Curtis-Milo/Capstone/RasberryPi/images/ceiling8.jpg

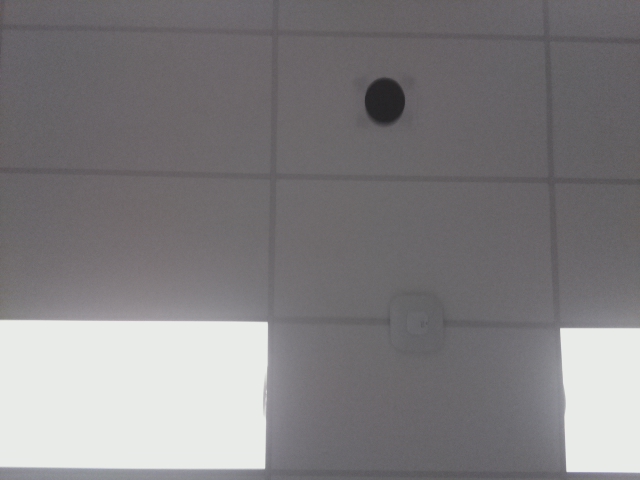
RasberryPi/images/ceiling8.jpg
