Curtis-Milo/Capstone/RasberryPi/images/ceiling1.jpg

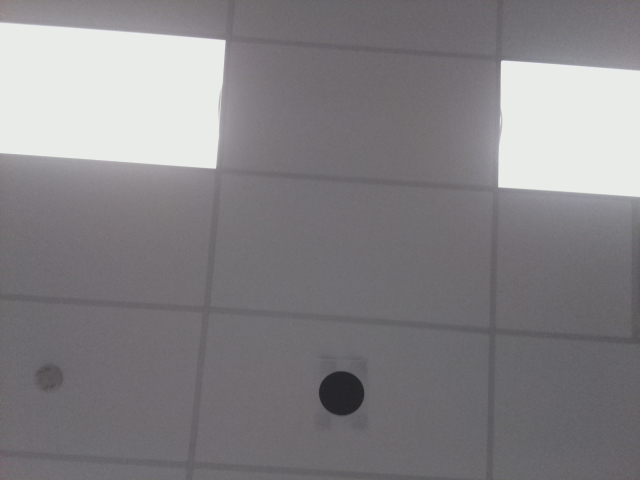
RasberryPi/images/ceiling1.jpg
