Curtis-Milo/Capstone/Documentation/5-System_Design/System_Design.tex

% Document uses 12 pt font
% 1 in margins
% Contains a relative path for images

\documentclass [10pt]{article}

% page geometry 
\usepackage[margin=1in]{geometry}

% ----------  PACKAGES START ------------ %
% Math Packages
\usepackage{amsmath}
\usepackage{mathtools}

% Table cell color package and highlighting
\usepackage[table,xcdraw]{xcolor}
\usepackage{color,soul}

% VIC title package
%\usepackage{cabin}
\usepackage[T1]{fontenc}

% default font package
%\usepackage{times}
\usepackage{helvet}
%\renewcommand{\familydefault}{\sfdefault}

% ---------- End Font Packages -------------- %

\usepackage{listings}

%\definecolor{dkgreen}{rgb}{0,0.6,0}
%\definecolor{gray}{rgb}{0.5,0.5,0.5}
%\definecolor{mauve}{rgb}{0.58,0,0.82}
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
\usepackage{longtable}
\usepackage{multirow}
\usepackage{multicol}
\usepackage{multirow}
\usepackage{array}
\renewcommand{\arraystretch}{1.2}% Spread rows out evenly in table
\setlength{\LTpre}{0.5pt} % Reduces white space around tables (top)
%\setlength{\LTpost}{0pt} % Reduces white space around tables (bottom)

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

% List package
\usepackage{enumitem}
\setenumerate{itemsep=0pt, itemindent=0in,leftmargin=0.5in}

% Paragraph parameter

\setlength{\parindent}{0pt}

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

% ------------- Creates a click-able Table of Contents  End--------------- %

% ---------- PACKAGES END ------------ %

% -------- SECTION AND SUBSECTION FORMATING START -------- % 
% starts the 
%\setcounter{section}{1}

\titleformat{\section} % Section
{\normalfont \fontsize{14}{14} \bfseries}{}{0em}{\colorsection}

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

% Makes a background color
\titleformat{\subsection} % Subsection
{\normalfont \fontsize{12}{12}  \bfseries}{}{0em}{\colorsubsection }

\newcommand{\colorsubsection}[1]{%
  \colorbox{subsectionC}{\parbox{\dimexpr \textwidth -1\fboxsep}{\large\thesubsection\ #1}}}

% Makes a background color
\titleformat{\subsubsection} % Subsubsection
{\normalfont \fontsize{12}{12} \bfseries}{}{0em}{\colorsubsubsection}

\newcommand{\colorsubsubsection}[1]{%
  \colorbox{subsubsectionC}{\parbox{\dimexpr\textwidth-1\fboxsep}{\thesubsubsection\ #1}}}

% -------- SECTION AND SUBSECTION FORMATING END -------- % 
\usepackage{lipsum}

% -----  IMAGE PATH START -----%
% Relative Image Path
\graphicspath {figures/}
% -----  IMAGE PATH END -----%

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

%------------------------------TOC FORMAT START --------------------------------%
\usepackage{tocloft}

% Section indentations
\cftsetindents{section}{0em}{1.5em}
\cftsetindents{subsection}{1em}{2em}
\cftsetindents{subsubsection}{2em}{3em}

% Toc title size
\renewcommand\cfttoctitlefont{\Large\bfseries}
\renewcommand*\contentsname{Table of Contents}

\newcommand{\carSpeed}{1.4\ m/s}
\newcommand{\intersectionLength}{0.6\ m}

% Removes bold headings from toc
%\renewcommand{\cftsecfont}{\normalfont}

% Removes bold heading page numbers from toc
\renewcommand{\cftsecpagefont}{\normalfont}

% add dots after headings
%\renewcommand{\cftsecleader}{\cftdotfill{\cftdotsep}} 

% number of section headings we want to see in toc
\setcounter{tocdepth}{2}

% Spaceing before headings in toc
\setlength{\cftbeforesecskip}{6pt}

% ------------------------------TOC FORMAT END --------------------------------%

% ------------------- START HEADER AND FOOTER ---------------------------%
\usepackage{fancyhdr}

% Helps with the n of total n pages
\usepackage{lastpage}

\pagestyle{fancy}

% Header
\lhead{Draft Component Design}
\rhead{Revision: 0}
\fancyhead[LE,CO]{Group 9: LazyBots}

% Removes line under the header 
\renewcommand{\headrulewidth}{0pt}
\setlength{\headsep}{.2in}

% Footer 

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

% ------------------- END HEADER AND FOOTER ---------------------------%

% -------------- DOCUMENT START ---------------%
\begin{document}

% --------- TITLE PAGE START ------- %
\begin {center} 

\thispagestyle{empty}
\vspace*{5cm}

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

{%\fontfamily{\cabinfamily}\selectfont
\Huge{LazyBots} }

\vspace{1 cm}
{\Large\textbf{\textsc{McMaster University}}\\}  \vspace {1cm}
{\Large Draft System Design\\ \vspace {0.4 cm} SE 4GA6 \& TRON 4TB6}  \vspace {1cm}

{\large \textsc{Group 9} \\} \vspace{1cm}

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

\end{center}

% --------- TITLE PAGE END------- %

\pagebreak

% Inserting table of contents and table of figures 

\tableofcontents
\listoftables
\listoffigures

\pagebreak

% -----------  REVISION HISTORY START ----------- %

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

\caption{LazyBots Table of Revisions} 
\end{longtable}

\pagebreak

%---------------------------- PROJECT DRIVERS ------------------------%
% heading in document

% -------------- START INTRODUCTION ---------------- %

% ------------------------------------------------------- PURPOSE ------------------------------------------------------- %
\section {Purpose}

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

% ------------------------------------------------------- Scope ------------------------------------------------------- %

\subsection{Scope}

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

% ------------------------------------------------------- Context Diagram ------------------------------------------------------- %

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

% ---------------------------------------------------- Diagram of Components ----------------------------------------------------- %

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

% ------------------------------------------------------------ Assumptions ------------------------------------------------------------- %

\subsection{Assumptions}

Alfred's assumption are represented in the tables below.  \\

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

\subsection{Components to Requirements}

% ------------------------------------------------------- SYSTEM VARIABLES ------------------------------------------------------- %

\section{System Variables}

% ---------------------------------------------- Monitored and Controlled Variables ----------------------------------------------- %

\subsection{Monitored and Controlled Variables}
The following is a list of variables that will be monitored. \\

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

The following is a list of variables that will be controlled. \\

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

% ------------------------------------------------------- Constants ------------------------------------------------------- %

\subsection{Constants}

The following is a list of system constants. \\

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

% ----------------------------------------------------- BEHAVIOUR OVERVIEW ---------------------------------------------------- %

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

% ------------------------------------------------ COMPONENT TRACEABILITY ------------------------------------------------- %

\section{Component Traceability}

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

\pagebreak

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

\pagebreak

% -------------------------------------------------- COMPONENT OVERVIEW ---------------------------------------------------- %

\section{Component Overview}

% ----------------------------------------------------- Ordering System Module ---------------------------------------------------- %
\subsection{Ordering System Module}

% ----------------------------------------------------- Description ---------------------------------------------------- %

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

% ----------------------------------------------------- Inputs and Outputs ---------------------------------------------------- %
\subsubsection{Inputs and Outputs}

\textbf{Inputs:}  User input defining:\\

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

\textbf{Outputs:} Packaged Information within HTTP Request for: \\

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

% ----------------------------------------------------- Exception Handling ---------------------------------------------------- %
\subsubsection{Exception Handling}

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

% ----------------------------------------------------- Timing Constriants ---------------------------------------------------- %

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

% ----------------------------------------------------- Initialization ---------------------------------------------------- %

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

% --------------------------------------------------- Manager Login Page Module -------------------------------------------------- %

\subsection{Manager Login Page Module}

% ----------------------------------------------------- Description ---------------------------------------------------- %

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

% ----------------------------------------------------- Inputs and Outputs ---------------------------------------------------- %

\subsubsection{Inputs and Outputs}

\textbf{Inputs: } \newline

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

\textbf{Outputs: } To be displayed to the user.\newline
\begin{longtable}{|l|l|l|l|l|}\hline 
	\rowcolor{tableCell}\textbf{Output Name} & \textbf{Output Type} & \textbf{Range} & \textbf{Units} & \textbf{Comment(s)} \\ \hline
	$  FailureMessage $ & String & 10 chars & N/A & Failure message if there is an incorrect information  \\ \hline
	\rowcolor{tableCell}$  GotoPage $ & Action & N/A  & N/A & navigating to the correct page if it was a success. \\ \hline
\end{longtable}

% ----------------------------------------------------- Exception Handling ---------------------------------------------------- %
\subsubsection{Exception Handling}

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

% ----------------------------------------------------- Timing Constraints ---------------------------------------------------- %

\subsubsection{Timing Constraints}
Given optimal networking conditions, the server must respond with $ t_{timeout} $ seconds.

% ----------------------------------------------------- Initialization ---------------------------------------------------- %

\subsubsection{Initialization}
This will default to a HTML page with no information.

% ------------------------------------------- Manager Station Map Software Module ------------------------------------------ %

\subsection{Manager Station Map Software Module}

% ----------------------------------------------------- Description ---------------------------------------------------- %

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

% ----------------------------------------------------- Inputs and Outputs ---------------------------------------------------- %

\subsubsection{Inputs and Outputs}

\textbf{Inputs:} User input defining:\\

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

\textbf{Outputs: }A text file that contains the following information. \\

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

% ----------------------------------------------------- Exception Handling ---------------------------------------------------- %
\subsubsection{Exception Handling}

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

% ----------------------------------------------------- Timing Constraints ---------------------------------------------------- %

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

% ----------------------------------------------------- Initialization ---------------------------------------------------- %

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

% ---------------------------------------- Manager Station Request Software Module ----------------------------------------- %

\subsection{Manager Station Request Software Module}

% ----------------------------------------------------- Description ---------------------------------------------------- %

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

% ----------------------------------------------------- Inputs and Outputs ---------------------------------------------------- %

\subsubsection{Inputs and Outputs}

\textbf{Inputs: } \\

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

% ----------------------------------------------------- Exception Handling ---------------------------------------------------- %
\subsubsection{Exception Handling}

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

% ----------------------------------------------------- Timing Constraints ---------------------------------------------------- %

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

% ----------------------------------------------------- Initialization ---------------------------------------------------- %

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

% ------------------------------------------------- Back End Web Service Module ------------------------------------------------ %

\subsection{Back End Web Service Module}

% ----------------------------------------------------- Description ---------------------------------------------------- %

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

% ----------------------------------------------------- Inputs and Outputs ---------------------------------------------------- %

\subsubsection{Inputs and Outputs}

\textbf{Inputs: } \\

\begin{longtable}{| p{.15\textwidth} | p{.15\textwidth} | p{.08\textwidth} | p{.06\textwidth} | p{.45\textwidth} |}\hline 
	\rowcolor{tableCell}\textbf{Input Name} & \textbf{Input Type} & \textbf{Range} & \textbf{Units} & \textbf{Comment(s)} \\ \hline
	$ HttpReq_{Orders} $ & HTTP Request & N/A & N/A & HTTP request package with the information for drink orders. \\ \hline
	\rowcolor{tableCell}$ Map_{textfile} $ & Text File & N/A & N/A & A text file with a map of the restaurant \\ \hline
	$  errors_{Alfred} $ & Unsigned Byte & [0, $2^{8}$]& N/A & Errors from Alfred \\ \hline
	\rowcolor{tableCell}$  UserName $ & String & 10 chars & N/A & N/A\\ \hline
	$  Password $ & HashCode & N/A & N/A &  Success result for authenticated results. \\ \hline
\end{longtable}

\textbf{Outputs: } \\

\begin{longtable}{| p{.15\textwidth} | p{.15\textwidth} | p{.08\textwidth} | p{.06\textwidth} | p{.45\textwidth} |}\hline 
	\rowcolor{tableCell}\textbf{Output Name} & \textbf{Output Type} & \textbf{Range} & \textbf{Units} & \textbf{Comment(s)} \\ \hline
	$ HttpReq_{Orders} $ & HTTP Request & N/A & N/A & HTTP request package with the information for drink orders. \\ \hline
	\rowcolor{tableCell}$ Map_{textfile} $ & Text File & N/A & N/A & A text file with a map of the restaurant \\ \hline
	$  errors_{Alfred} $ & Unsigned Byte & [0, $2^{8}$]& N/A & Errors from Alfred \\ \hline
	\rowcolor{tableCell}$  Login_{Status} $ & String & 10 chars & N/A & Login Success or Fail \\ \hline
	$  Http_{Result} $ & String & 10 chars & N/A & N/A\\ \hline
\end{longtable}

% ----------------------------------------------------- Exception Handling ---------------------------------------------------- %
\subsubsection{Exception Handling}

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

% ----------------------------------------------------- TIming Constraints ---------------------------------------------------- %

\subsubsection{Timing Constraints}
Given optimal networking conditions, the server must respond with  $ t_{timeout} $ seconds.

% ----------------------------------------------------- Initialization ---------------------------------------------------- %

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

% ----------------------------------------------------- Alfred Manager Module ---------------------------------------------------- %

\subsection{Alfred Manager Module}

% ----------------------------------------------------- Description ---------------------------------------------------- %

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

% ----------------------------------------------------- Inputs and Outputs ---------------------------------------------------- %

\subsubsection{Inputs and Outputs}

\textbf{Inputs: } \\

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

\textbf{Outputs: } \\

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

% ----------------------------------------------------- Exception Handling ---------------------------------------------------- %
\subsubsection{Exception Handling}

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

% ----------------------------------------------------- TIming Constraints ---------------------------------------------------- %

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

% ----------------------------------------------------- Initialization ---------------------------------------------------- %

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

% --------------------------------------------- Raspberry Pi Specifications -------------------------------------------- %

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

% --------------------------------------------- Alfred Drive-Train Module -------------------------------------------- %

\subsection{Alfred Drive-Train Module}

% --------------------------------------------- Description -------------------------------------------- %

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

% --------------------------------------------- Inputs and Outputs -------------------------------------------- %

\subsubsection{Inputs and Outputs}

\textbf{Inputs: } \\

\begin{longtable}{| p{.15\textwidth} | p{.15\textwidth} | p{.15\textwidth} | p{.06\textwidth} | p{.45\textwidth} |}\hline 
	\rowcolor{tableCell}\textbf{Input Name} & \textbf{Input Type} & \textbf{Range} & \textbf{Units} & \textbf{Comment(s)} \\ \hline
	$ Map $ & Graph & N/A & N/A & Graph of the text file with a map of the restaurant \\ \hline
	\rowcolor{tableCell}$ NextNode $ & Node & [(0,0), (length($Map)$, width($Map$)] & N/A & The next node to travel to \\ \hline
	$ w_{wheel_{left}} $ & Float & [0, $ 100 $]& rad/s &  Left Encoder Input\\ \hline
	\rowcolor{tableCell}$ w_{wheel_{right}} $ & Float & [0, $ 100 $]& rad/s & Right Encoder Input \\ \hline
	$  d_{objects} $ & Float[] & [0, 10.0]& m &  N/A\\ \hline
	\rowcolor{tableCell}$ Marker_{PosX} $ & Unsigned Integer & [0,$2^{16}$] & Pixels &  N/A\\ \hline
	$ Marker_{PosY} $ & Unsigned Integer & [0,$2^{16}$] & Pixels & N/A\\ \hline
	\rowcolor{tableCell}$ b_{NextMarkerFound} $ & Boolean & [0,1] & N/A & N/A \\ \hline
	$  V_{batt} $ & Float & [0, 20.0]& m &  N/A\\ \hline
\end{longtable}

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

% ----------------------------------------------------- Exception Handling ---------------------------------------------------- %
\subsubsection{Exception Handling}

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

% --------------------------------------------- Timing Constraints -------------------------------------------- %

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

% --------------------------------------------- Initialization -------------------------------------------- %

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

% --------------------------------------------- Diagram of Simulink System -------------------------------------------- %

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

% --------------------------------------------- Diagram of Simulink System -------------------------------------------- %

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

% --------------------------------------------- DC Motor Specifications -------------------------------------------- %

\subsubsection{DC Motor Specifications}
Manufactured Part Number: 393111-01\\
Rated Voltage: 18V\\
Current: 3A-5A\\

% --------------------------------------------- H-Bridge Specifications -------------------------------------------- %

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

% --------------------------------------------- Encoder Specifications -------------------------------------------- %

\subsubsection{Encoder Specifications}
Shaft Diameter 6mm\\
Working Range: 3-5V DC\\

% --------------------------------------------- Alfred Pumping System Module -------------------------------------------- %

\subsection{Alfred Pumping System Module}

% --------------------------------------------- Description -------------------------------------------- %

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

% --------------------------------------------- Inputs and Outputs -------------------------------------------- %

\subsubsection{Inputs and Outputs}

\textbf{Inputs: } \\

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

\textbf{Outputs: } \\

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

% ----------------------------------------------------- Exception Handling ---------------------------------------------------- %
\subsubsection{Exception Handling}

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

% --------------------------------------------- TIming Constraints -------------------------------------------- %

\subsubsection{Timing Constraints}
This module will have to dispense the drink within $ t_{maxpump} $

% --------------------------------------------- Initialization -------------------------------------------- %

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

% --------------------------------------------- Diagram of DC Pump Control System -------------------------------------------- %

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

% --------------------------------------------- DC Pump Circuit Diagram -------------------------------------------- %

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

\pagebreak

% --------------------------------------------- Liquid Temperature Circuit Diagram -------------------------------------------- %

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

% --------------------------------------------- Weight Detection Circuit Diagram -------------------------------------------- %

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

% --------------------------------------------- DC Pump Specifications -------------------------------------------- %

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

% --------------------------------------------- Arduino Mega Specifications -------------------------------------------- %

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

% --------------------------------------------- Container Specifications -------------------------------------------- %

\subsubsection{Container Specifications} 

Manufacture : Rubbermaid \\
Dimensions: 10 1/2" x 9" x 4" 
Capacity: 18 Cups/4.2 L\\

% --------------------------------------------- Tubing Specifications -------------------------------------------- %

\subsubsection{Tubing Specifications}
Manufacture : Plumb Craft \\
Diameter: 1/4"ID Food Grade Tubing will be used.\\

% --------------------------------------------- Alfred Image Processing Module -------------------------------------------- %

\subsection{Alfred Image Processing Module }

% --------------------------------------------- Description -------------------------------------------- %

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

% --------------------------------------------- Inputs and Outputs -------------------------------------------- %

\subsubsection{Inputs and Outputs}

\textbf{Inputs: } \\

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

\textbf{Outputs: } \\

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

% ----------------------------------------------------- Exception Handling ---------------------------------------------------- %
\subsubsection{Exception Handling}

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

% --------------------------------------------- Timing Constraints -------------------------------------------- %

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

% --------------------------------------------- Initialization -------------------------------------------- %

\subsubsection{Initialization}
This module start by the drive-train application.

% --------------------------------------------- Raspberry Pi Specifications -------------------------------------------- %

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

% --------------------------------------------- Modules Likelihood of Change -------------------------------------------- %

\section{Likelihood of Change}

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

\multicolumn{1}{|c|}{Manager Login Page Module}& 
\multicolumn{1}{|c|}{Very Unlikely} & Key implementation aspect \\ \hline

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

\multicolumn{1}{|c|}{Alfred Manager Module}& 
\multicolumn{1}{|c|}{Very Unlikely} & Key implementation aspect \\ \hline

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

\multicolumn{1}{|c|}{Alfred Image Processing Module}& 
\multicolumn{1}{|c|}{Very Unlikely} & Key implementation aspect \\ \hline

\end{longtable}

% --------------------------------------------- Normal Operation -------------------------------------------- %

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

% --------------------------------------------- Undesired Event Handling -------------------------------------------- %

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

% --------------------------------------------- References -------------------------------------------- %

\section{References}

\textbf{Raspberry pi data sheet}
\begin{verbatim}
[1]"Exploring Raspberry Pi", 2017. [Online]. 
Available: http://docs-europe.electrocomponents.com/webdocs/14ba/0900766b814ba5fd.pdf. 
[Accessed: 23- Dec- 2017].
\end{verbatim}

\textbf{Arduino Mega Information}
\begin{verbatim}
[2] "Arduino Mega". [Online]. Available:
https://www.arduino.cc/en/Main/ArduinoBoardMega. [Accessed: 23- Dec- 2017].
\end{verbatim}

\textbf{DC Pump Information}
\begin{verbatim}
[3] "3-6V Mini Micro Submersible Pumps DC Motor Pump Water Pump - 80-120L/H". [Online]. 
Available: 
https://www.amazon.ca/gp/product/B01LWQCXEL/ref=oh_aui_detailpage_o02_s00?ie=UTF8&psc=1.
[Accessed: 23- Dec- 2017].
\end{verbatim}
\textbf{Pump Container Information}
\begin{verbatim}
[4] "Rubbermaid 1856059 Modular Cereal Keeper". [Online]. 
Available: 
https://www.amazon.ca/gp/product/B00BEUDXRW/ref=oh_aui_detailpage_o09_s00?ie=UTF8&psc=1. 
[Accessed: 23- Dec- 2017].
\end{verbatim}

\textbf{Raspberry camera pi data sheet}
\begin{verbatim}
[4] "CAMERA MODULE". [Online]. Available:
https://www.raspberrypi.org/documentation/hardware/camera/. [Accessed: 23- Dec- 2017].
\end{verbatim}
\end{document}
