Curtis-Milo/Capstone/Documentation/2-Project_Goals/Goals.tex

% Document uses 12 pt font
% 1 in margins
% Contains a relative path for images

\documentclass [11pt]{article}

% page geometry 
\usepackage[margin=1in]{geometry}

% ----------  PACKAGES START ------------ %

% Table cell color
\usepackage[table]{xcolor}

% VIC title package
\usepackage{cabin}
\usepackage[T1]{fontenc}

% default font package
%\usepackage{times}
\usepackage{helvet}
%\renewcommand{\familydefault}{\sfdefault}

% ---------- End Font Packages -------------- %

% Title Packages
\usepackage{titlesec}
\usepackage{titletoc}

% Image Package
\usepackage{graphicx}

% Table Packages
\usepackage{longtable}
\usepackage{multirow}
\usepackage{multicol}
\usepackage{multirow}
\usepackage{array}
\renewcommand{\arraystretch}{1.2}% Spread rows out evenly in table

% Color Packages
\usepackage{color}   
\definecolor{sectionC}{rgb}{0.95,0.52,.0}
\definecolor{subsectionC}{rgb}{1.0,.64,.26}
\definecolor{subsubsectionC}{rgb}{1.0,.87,.68}
\definecolor{tableCell}{rgb}{.98,.81,.69}

% List package
\usepackage{enumitem}
\setenumerate{itemsep=0pt, itemindent=0in,leftmargin=0.5in}

% Paragraph parameter

\setlength{\parindent}{0pt}

% ------------- Creates a linked Table of Contents  Start --------------- %
\usepackage{hyperref}
\hypersetup{
colorlinks=true, %set true if you want colored links
linktoc=all,     %set to all if you want both sections and subsections linked
linkcolor=black,}  %choose some color if you want links to stand out

% ------------- Creates a click-able Table of Contents  End--------------- %

% ---------- PACKAGES END ------------ %

% ------------------- START HEADER AND FOOTER ---------------------------%
\usepackage{fancyhdr}

% Helps with the n of total n pages
\usepackage{lastpage}

\pagestyle{fancy}

% Header
\lhead{Project Goals }
\rhead{Revision: 2}
\fancyhead[LE,CO]{Group 9: LazyBots}

% Removes line under the header 
\renewcommand{\headrulewidth}{0pt}
\setlength{\headsep}{.2in}

% Footer 

% Set the right side of the footer to be the page number
\fancyfoot[R]{Page \textbf{\thepage}\ of \textbf{\pageref{LastPage}}}
\fancyfoot[C]{}

% ------------------- END HEADER AND FOOTER ---------------------------%

% ------------------- START ROTATE FOOTER ---------------------------%
\usepackage{everypage}

\newcommand{\Lpagenumber}{\ifdim\textwidth=\linewidth\else\bgroup
  \dimendef\margin=0
  \ifodd\value{page}\margin=\oddsidemargin
  \else\margin=\evensidemargin
  \fi
  \raisebox{\dimexpr -\topmargin-\headheight-\headsep-.8\linewidth}[0pt][0pt]{%
    \rlap{\hspace{\dimexpr \margin+\textheight}%
    \llap{\rotatebox{0}{Page \textbf{\thepage}\ of \textbf{\pageref{LastPage}}}}}}%
\egroup\fi}
\AddEverypageHook{\Lpagenumber}%

% ------------------- END ROTATE FOOTER ---------------------------%

% -------- SECTION AND SUBSECTION FORMATING START -------- % 
% starts the 
%\setcounter{section}{1}

\titleformat{\section} % Section
{\normalfont \fontsize{14}{14} \bfseries}{}{0em}{\colorsection}

% Makes a background color
\newcommand{\colorsection}[1]{%
  \colorbox{sectionC}{\parbox{\dimexpr\textwidth-1\fboxsep}{\color{black}\Large\thesection\ \hspace{1mm} #1}}}

% Makes a background color
\titleformat{\subsection} % Subsection
{\normalfont \fontsize{12}{12}  \bfseries}{}{0em}{\colorsubsection }

\newcommand{\colorsubsection}[1]{%
  \colorbox{subsectionC}{\parbox{\dimexpr \textwidth -1\fboxsep}{\large\thesubsection\ #1}}}

% Makes a background color
\titleformat{\subsubsection} % Subsubsection
{\normalfont \fontsize{12}{12} \bfseries}{}{0em}{\colorsubsubsection}

\newcommand{\colorsubsubsection}[1]{%
  \colorbox{subsubsectionC}{\parbox{\dimexpr\textwidth-1\fboxsep}{\thesubsubsection\ #1}}}

% -------- SECTION AND SUBSECTION FORMATING END -------- % 
\usepackage{lipsum}

% -----  IMAGE PATH START -----%
% Relative Image Path
\graphicspath {figures/}
% -----  IMAGE PATH END -----%

% ------ PARAGRAPH FORMAT START ----%
%\setlength{\parskip}{.2em}% Sets the space between new paragraph items 
\setlength{\parindent}{0em} % paragraph indent
% ------ PARAGRAPH FORMAT END ----%

%------------------------------TOC FORMAT START --------------------------------%
\usepackage{tocloft}

% Section indentations
\cftsetindents{section}{0em}{1.5em}
\cftsetindents{subsection}{1em}{2em}
\cftsetindents{subsubsection}{2em}{3em}

% Toc title size
\renewcommand\cfttoctitlefont{\Large\bfseries}
\renewcommand*\contentsname{Table of Contents}

% Removes bold headings from toc
%\renewcommand{\cftsecfont}{\normalfont}

% Removes bold heading page numbers from toc
\renewcommand{\cftsecpagefont}{\normalfont}

% add dots after headings
%\renewcommand{\cftsecleader}{\cftdotfill{\cftdotsep}} 

% number of section headings we want to see in toc
\setcounter{tocdepth}{2}

% Spaceing before headings in toc
\setlength{\cftbeforesecskip}{6pt}

% ------------------------------TOC FORMAT END --------------------------------%

% -------------- DOCUMENT START ---------------%
\begin{document}
% --------- TITLE PAGE START ------- %
\begin {center} 

\thispagestyle{empty}
\vspace*{5cm}

% Logo Insertion
\begin {figure}[h!]
\centering
\hspace{-10mm}\includegraphics [scale = .3, trim={.4cm 0 .8cm 0},clip] {figures/alfred.png}
\end {figure}

{\fontfamily{\cabinfamily}\selectfont
\Huge{LazyBots} }

\vspace{1 cm}
{\Large\textbf{\textsc{McMaster University}}\\}  \vspace {1cm}
{\Large Project Goals\\ \vspace {0.4 cm} SE 4GA6 \& TRON 4TB6}  \vspace {1cm}

{\large \textsc{Group 9} \\} \vspace{1cm}

\begin{tabular}{ l c  l}
Karim Guirguis & & 001307668 \\
David Hemms & & 001309228 \\
Marko Laban & & 001300989 \\
Curtis Milo & & 001305877 \\
Keyur Patel & & 001311559 \\
Alexandra Rahman & & 001305735
\end{tabular}

\end{center}

% ------------------------------------------------------- TITLE PAGE END -------------------------------------------------------- 

\pagebreak

% ------------------------------------------------------- Contents Guide -------------------------------------------------------

\tableofcontents
\listoftables

\pagebreak

% ------------------------------------------------------- Revision History -------------------------------------------------------

\section{Revisions}
\begin{longtable}{| p{.23\textwidth } | p{.23\textwidth } | p{.23\textwidth } | p{.21\textwidth } |}
\hline 
\centering \textbf{Date} & 
\multicolumn{1}{c}{\textbf {Revision Number}} &
\multicolumn{1}{|c}{\textbf {Authors}} & 
\multicolumn{1}{|c|}{\textbf {Comments}} \\ \hline

\multirow{4}{*}{\centering October 5\textsuperscript{th}, 2017}  & 
\multirow{4}{*}{Revision 0}& 
		{Karim Guirguis \newline
		David Hemms \newline
		Marko Laban \newline
		Curtis Milo \newline
		Keyur Patel \newline
		Alexandra Rahman} &
 \multirow{4}{*}{-} \\ 
\hline 

\multirow{4}{*}{\centering December 14\textsuperscript{th}, 2017}  & 
\multirow{4}{*}{Revision 1}& 
		{Karim Guirguis \newline
		David Hemms \newline
		Marko Laban \newline
		Curtis Milo \newline
		Keyur Patel \newline
		Alexandra Rahman} &
{Made one of the extended goals a project goal.} \\
\hline 

\multirow{4}{*}{\centering February 25\textsuperscript{th}, 2018}  & 
\multirow{4}{*}{Revision 2}& 
		{Karim Guirguis \newline
		David Hemms \newline
		Marko Laban \newline
		Curtis Milo \newline
		Keyur Patel \newline
		Alexandra Rahman} &
{Fixed layout and grammatical errors. Revised all project goals, specifically G6.} \\
\hline 

\caption{Table of Revisions}
\end{longtable}

\pagebreak

% ------------------------------------------------------ Problem Statement -----------------------------------------------------

\section{Problem Statement}

\indent\indent Many restaurants experience a rush of customers which can overwhelm serving staff as they juggle multiple tasks. Simple tasks such as getting drinks and refilling them can be costly, time wise, for a server and are often one of the first tasks overlooked. Thus leaving the customers unattended or with a feeling of neglect. Alfred is a serving assist that aims to remedy this problem by serving drinks to customers table-side. Alfred will arrive at the customer's table once an order has been placed and received, then will dispense the drink without the need to involve the server. 

% ------------------------------------------------------ Product Purpose -----------------------------------------------------

\section{Product Purpose}

\indent\indent Alfred will allow customers to order drinks through an application, after which Alfred will then navigate its way to their table to dispense the drinks ordered. Furthermore, Alfred will be able to identify objects in its path or tripping hazards and handle each scenario with the appropriate reaction. To ensure safety measures are met, Alfred will return to home base when the temperature of the liquids exceeds industry standard, the liquid supply levels are below a set amount or if the power supply is running low.

% -------------------------------------------------- Goals that Constitute Success -------------------------------------------------

\section{Project Goals that Constitute Success }
The minimum criteria for success of this project are as follows:

\begin{enumerate}[label=M\arabic*:, ref =\arabic*, leftmargin=0.5in]

	\item Alfred will be able to receive drink orders from an interface.
	\item Alfred will follow a predetermined path.
	\item Alfred will be able to arrive at the table who has placed an order.
	\item Alfred will dispense drinks autonomously.
	\item Alfred will notify the user that a drink is ready.
	
\end{enumerate}

% ------------------------------------------------------ Project Goals -----------------------------------------------------

\section{Project Goals}
The goals that constitute success are as follows:

\begin{enumerate}[label=G\arabic*:, ref =\arabic*, leftmargin=0.5in]
	
	\item Alfred will stay within the predetermined pathways.
	\item Alfred will conform to the food safety standards. 
	\item Alfred will return to home base when power supply and supply levels are low as well as when food safety standards are not met.
	\item Alfred will avoid obstacles and tripping hazards along pathways.
	\item Alfred will reduce product waste and over-pouring.	
	\item Alfred will allow the users to create and modify restaurant layouts through an interface.

\end{enumerate}

% ------------------------------------------------------ Extended Goals -----------------------------------------------------
\section{Extended Project Goals}
The goals that will exceed the definition of success are as follows: 

\begin{enumerate}[label=E\arabic*:, ref =\arabic*, leftmargin=0.5in]	

	\item Alfred will be modular to allow integration of existing POS (point-of-sale) systems.
	\item Alfred will be able to dispense correct amounts of liquid for different cup sizes.

\end{enumerate}

\end{document}
