Curtis-Milo/Capstone/Documentation/8-Presentation/Capstone.pptx

## LazyBots

Sfwr eng 4G06A & Tron 4TB6a

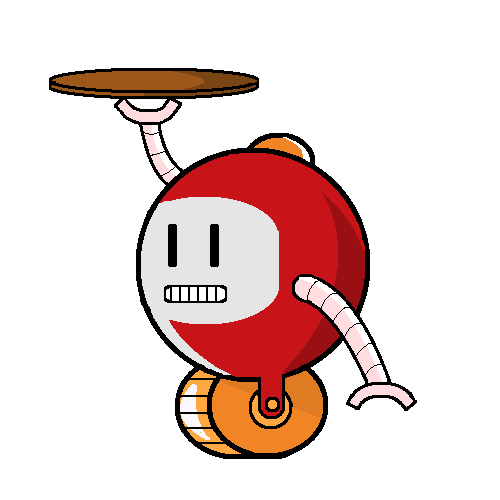
[picture p31: figure]

## Meet the Team

- Karim Guirguik
- David Hemms
- Marko Laban
- Curtis Milo
- Keyur Patel
- Alexandra Rahman
- Alfred

Photo of the Team in alphabetical order

## Meet Alfred

- A new take on a dumb waiter
- A self driving robot
- A drink dispenser

Picture of Alfred

## How Alfred Interacts in Social Settings

- Restaurant Client
- A user orders a drink via Android App
- Alfred will navigate to the customers table
- The correct drink will be dispensed
- Alfred will return to Home Base

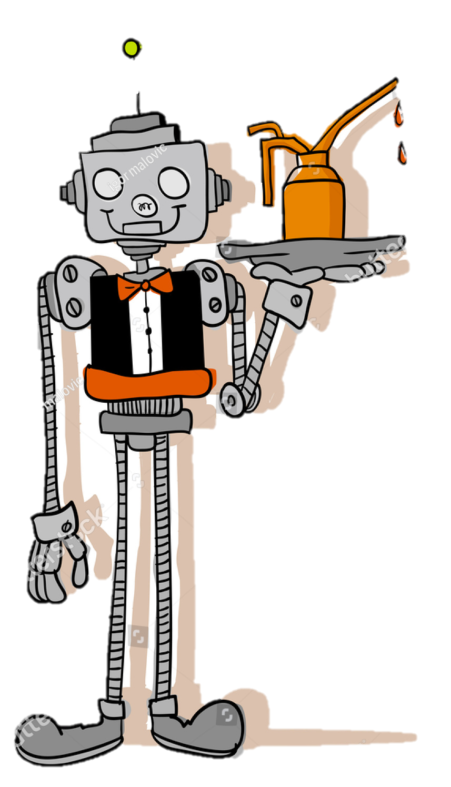
[picture p32: figure]

## How Alfred Interacts with Staff

- Restaurant Staff
- Staff will refill the drink containers
- Staff will change out the power supply
- Restaurant Management
- Management will be able to create and modify restaurant layout
- Management will be able to assign available drinks
- Management will be able to view error reports
- Management will be able to call Alfred to Home Base

## Layout of Restaurant

Layout of the restsurant

## Alfred in Action

Demo of Alfred

## The Magic Behind Alfred

- The Mechanical Design

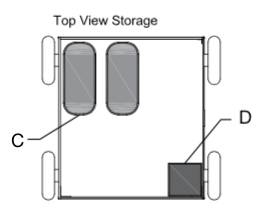
[picture p33: figure]
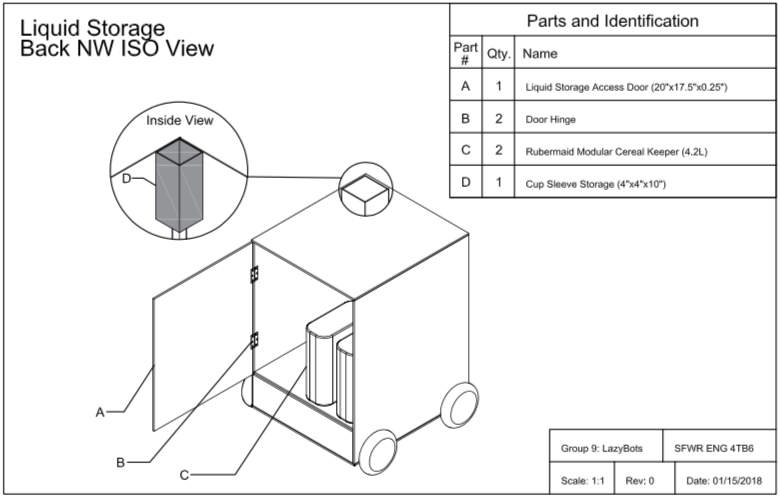
[picture p34: figure]
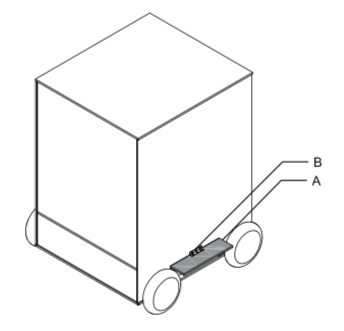
[picture p35: figure]

## The Magic Behind Alfred

- Electrical Design

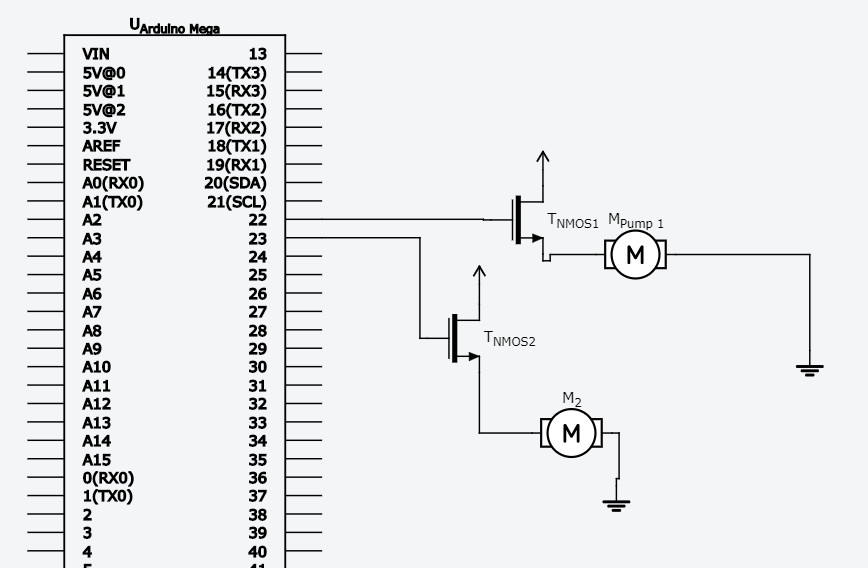
[picture p36: figure]
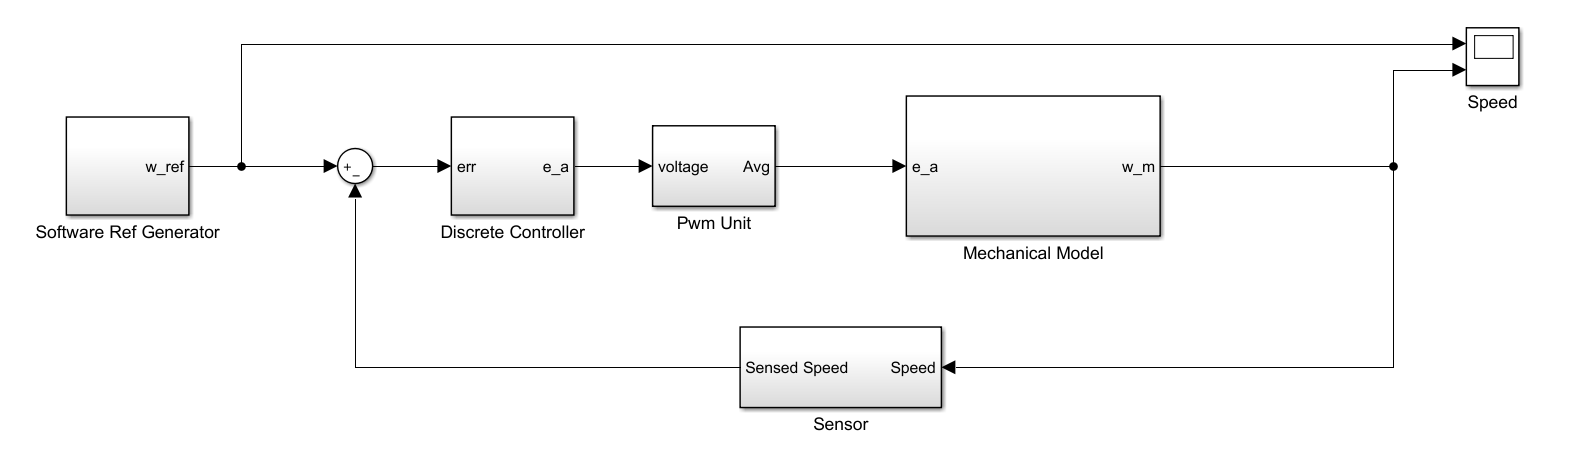
[picture p37: figure]

## The Magic Behind Alfred

- Software Design


## Future Enhancements

- Integrate Alfred’s system to existing Point of Sale Systems
- Upgrading the Dispensing System

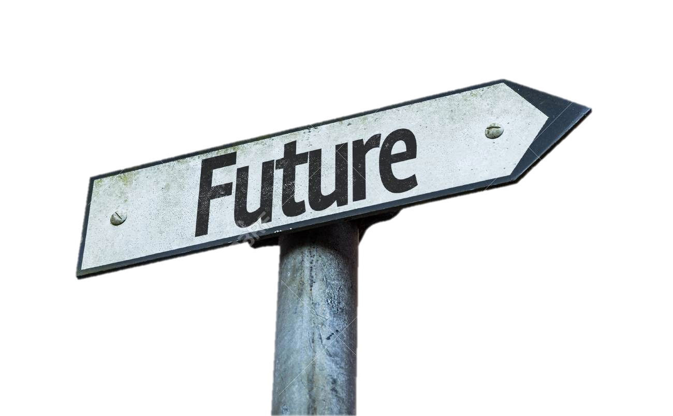
[picture p38: figure]
