Curtis-Milo/Capstone/Documentation/1-Project_Justification/CapstoneProjectJustification.docx

# Name of Group

Lazy Bots

# Group Members

Karmin Guirguis – Software Engineering and Embedded Systems

David Hemms – Software Engineering

Curtis Milo – Software Engineering and Embedded Systems

Keyur Patel – Software Engineering

Alexandra Rahman – Software Engineering and Embedded Systems

Marko Sam – Software Engineering and Embedded Systems

# Description

We propose to redesign a robot that will serve drinks to customers at a restaurant. The project is a modified version of one GM proposed, an autonomous driving robot. The robot will be able to navigate around a one-storey restaurant and prepare drinks based on the client’s choice. The autonomous driving robot will be paired with an android application that will allow a table to order their drink from a menu. The order is then relayed to the robot, which will arrive at the table and dispense the appropriate drink based off of a queuing system. Once the drink is dispensed the user will be notified that the drink is ready.
