Curtis-Milo/Capstone/CAD_Models/gearbox/IMAGES/screenshot_01_preview_featured.jpg

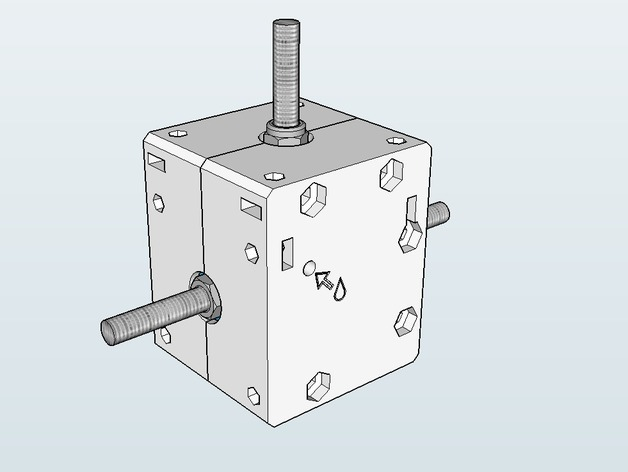
CAD_Models/gearbox/IMAGES/screenshot_01_preview_featured.jpg
