Curtis-Milo/Capstone/Documentation/8-Presentation/figures/ceiling.gif

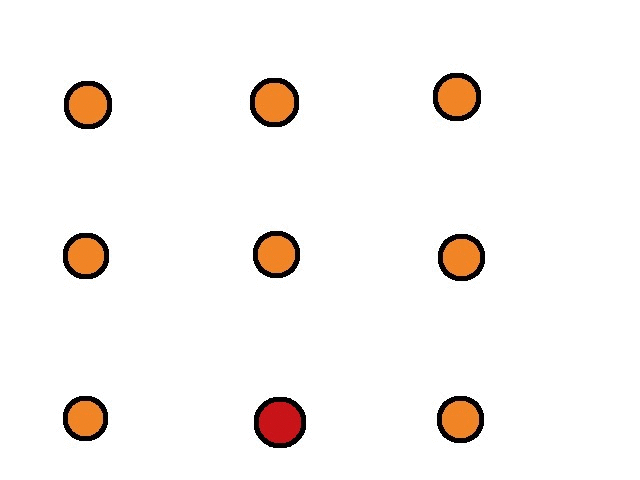
Documentation/8-Presentation/figures/ceiling.gif
