Curtis-Milo/Capstone/Documentation/8-Presentation/figures/Mapping System.png

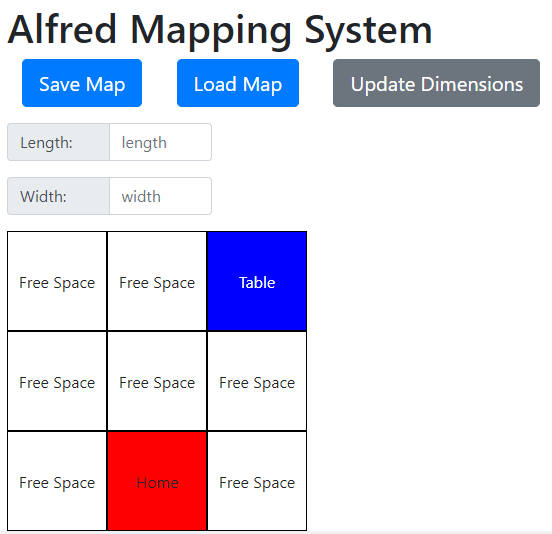
Documentation/8-Presentation/figures/Mapping System.png
