Curtis-Milo/Capstone/Documentation/8-Presentation/figures/Simulink.png

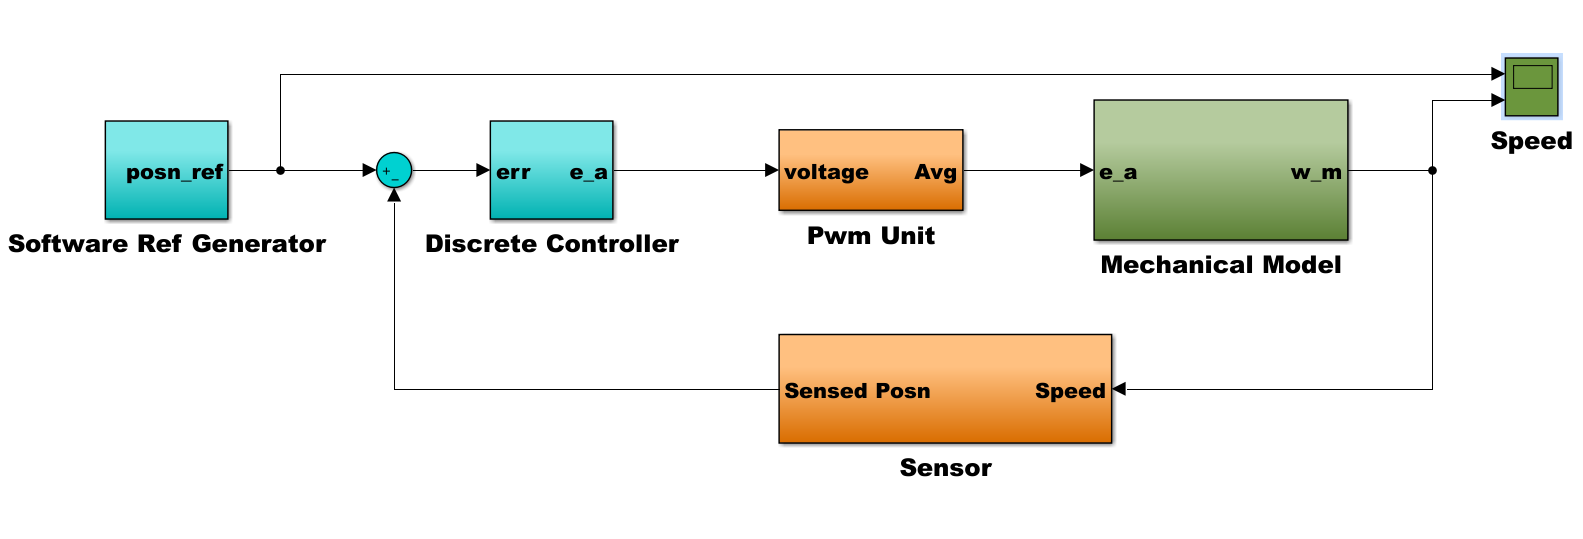
Documentation/8-Presentation/figures/Simulink.png
