Curtis-Milo/Capstone/Documentation/8-Presentation/figures/software_design.gif

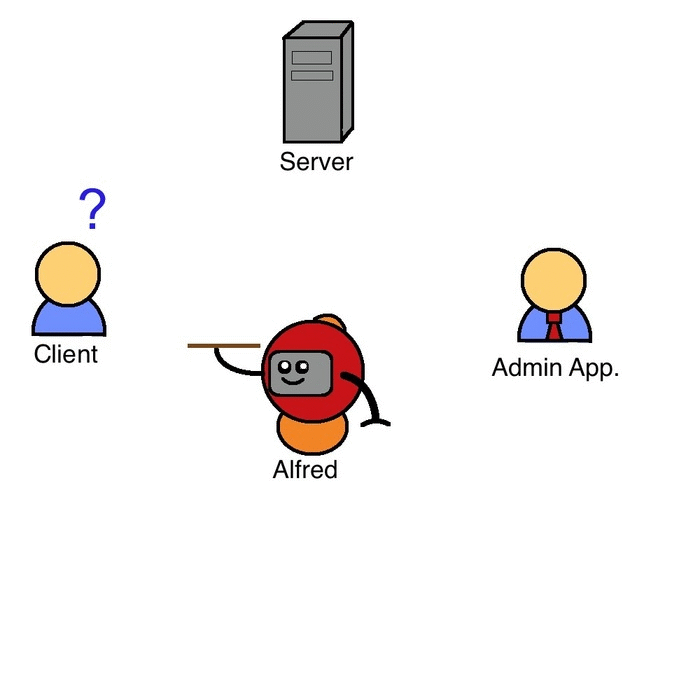
Documentation/8-Presentation/figures/software_design.gif
