Curtis-Milo/Capstone/Documentation/10-Design_Doc/figures/CAD_Battery.png

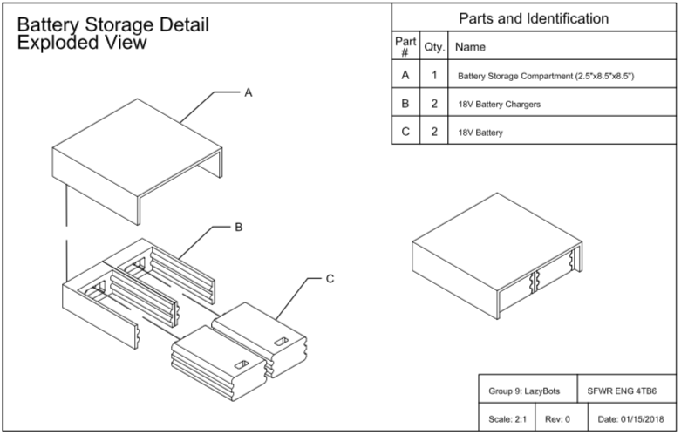
Documentation/10-Design_Doc/figures/CAD_Battery.png
