Curtis-Milo/Capstone/Documentation/10-Design_Doc/figures/CAD_Bottom_GB.png

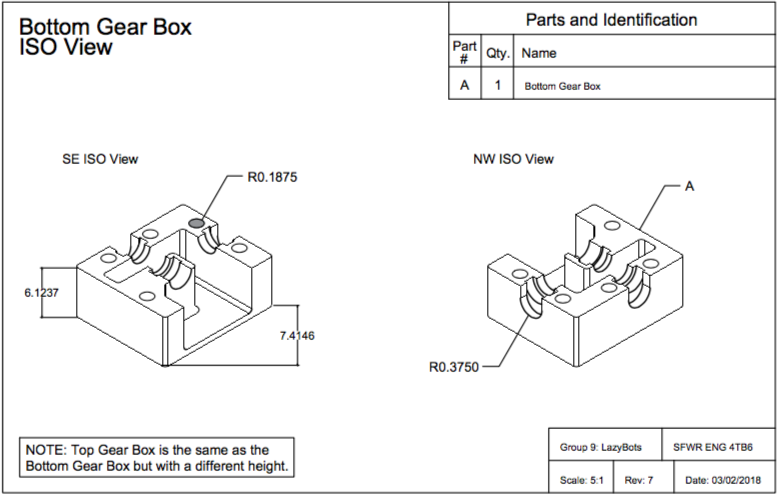
Documentation/10-Design_Doc/figures/CAD_Bottom_GB.png
