Curtis-Milo/Capstone/Documentation/10-Design_Doc/figures/CAD_Electrical_Storage.png

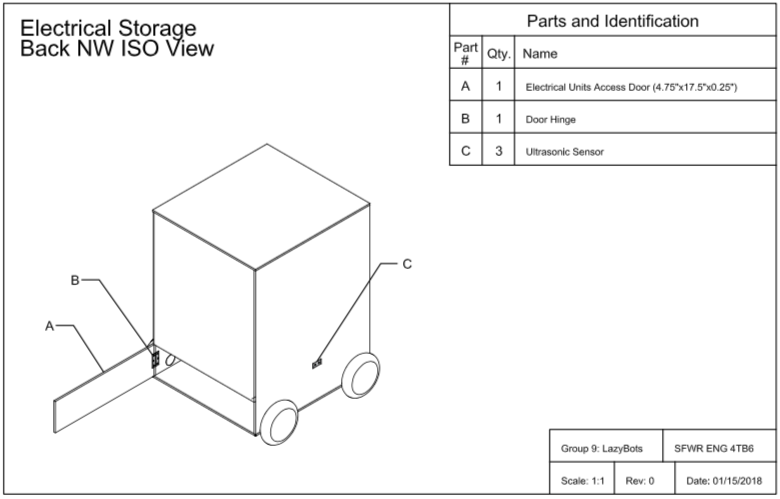
Documentation/10-Design_Doc/figures/CAD_Electrical_Storage.png
