Curtis-Milo/Capstone/Documentation/10-Design_Doc/figures/CAD_Front_View.png

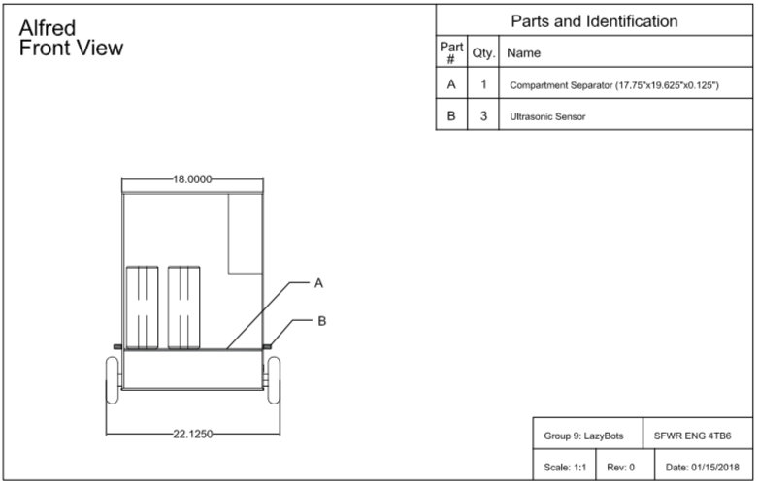
Documentation/10-Design_Doc/figures/CAD_Front_View.png
