Curtis-Milo/Capstone/Documentation/10-Design_Doc/figures/CAD_Motor_Mount.png

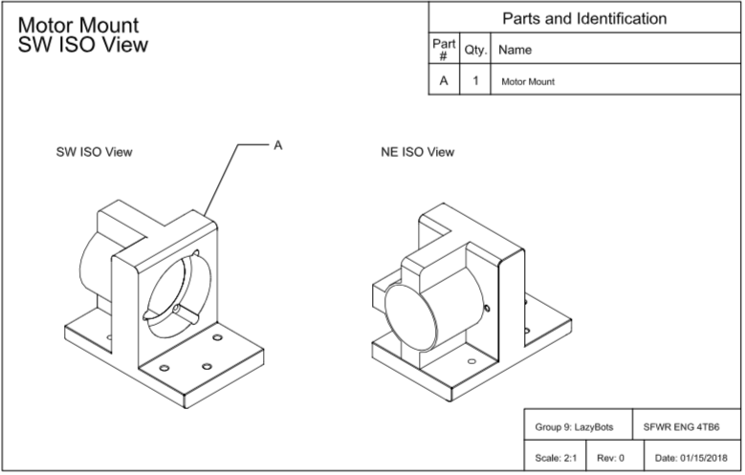
Documentation/10-Design_Doc/figures/CAD_Motor_Mount.png
