Curtis-Milo/Capstone/Documentation/10-Design_Doc/figures/CAD_Pumping_System.png

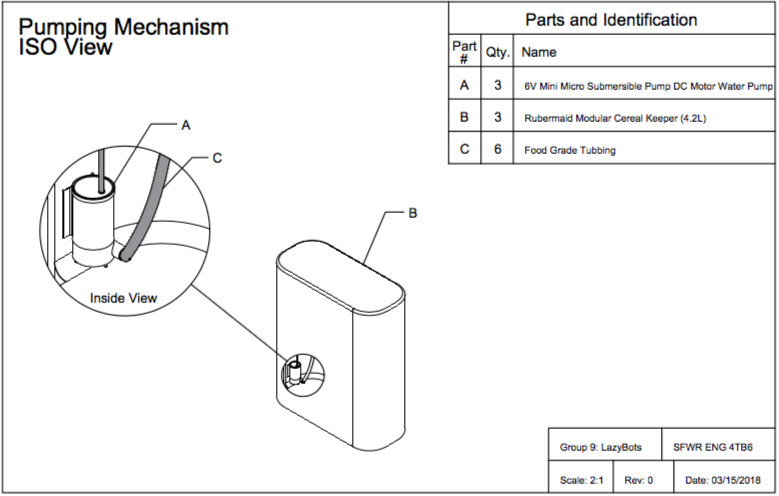
Documentation/10-Design_Doc/figures/CAD_Pumping_System.png
