Curtis-Milo/Capstone/Documentation/10-Design_Doc/figures/DC_PumpSim.png

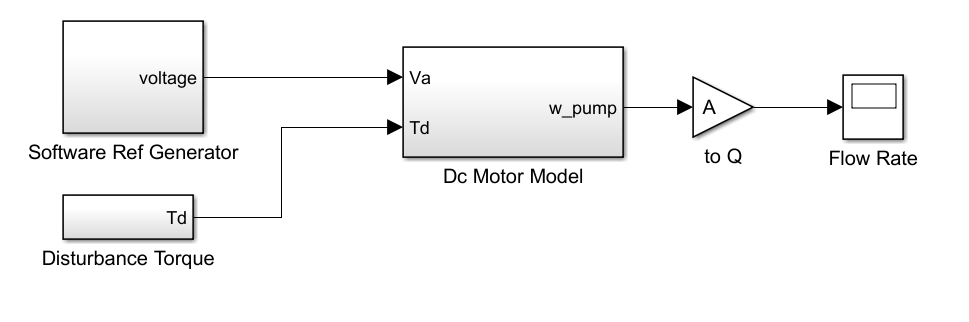
Documentation/10-Design_Doc/figures/DC_PumpSim.png
