Curtis-Milo/Capstone/Documentation/10-Design_Doc/figures/UART.png

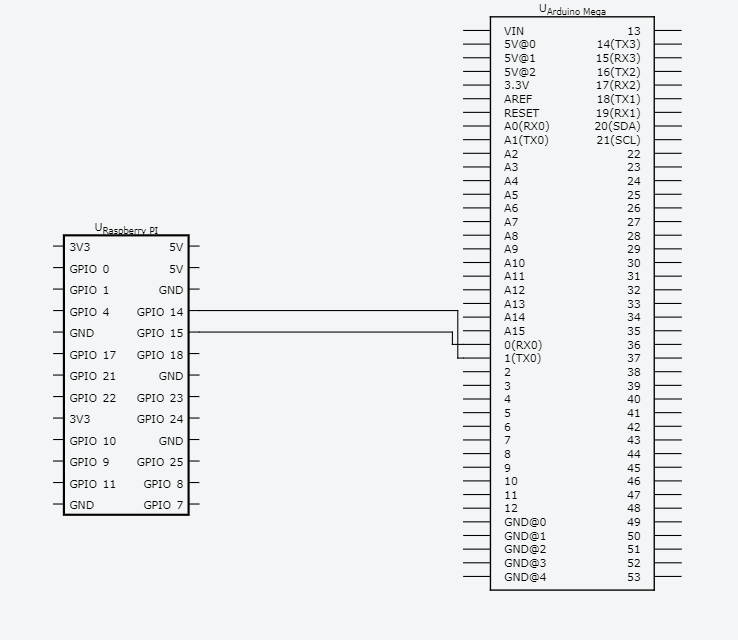
Documentation/10-Design_Doc/figures/UART.png
