Curtis-Milo/Capstone/RasberryPi/images/ceiling2.jpg

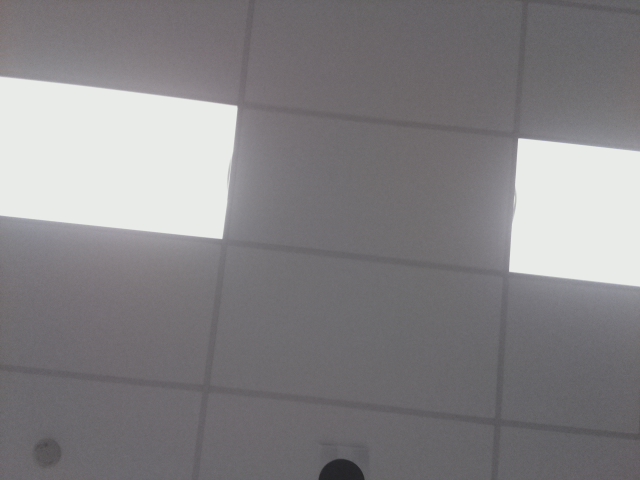
RasberryPi/images/ceiling2.jpg
