Curtis-Milo/Capstone/RasberryPi/images/ceiling3.jpg

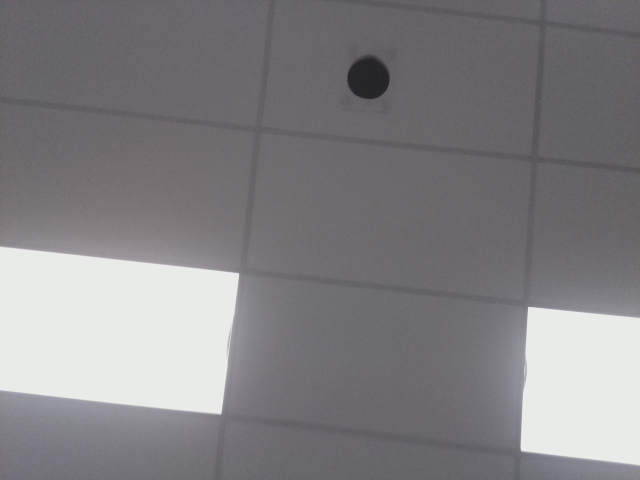
RasberryPi/images/ceiling3.jpg
