Curtis-Milo/Capstone/RasberryPi/images/ceiling4.jpg

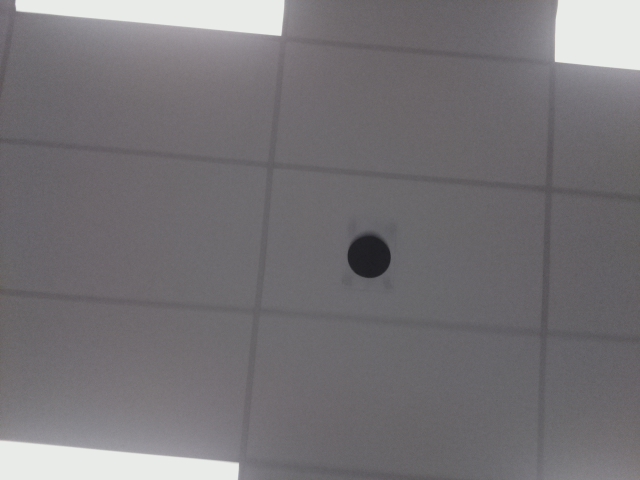
RasberryPi/images/ceiling4.jpg
