Curtis-Milo/Capstone/RasberryPi/images/ceiling5.jpg

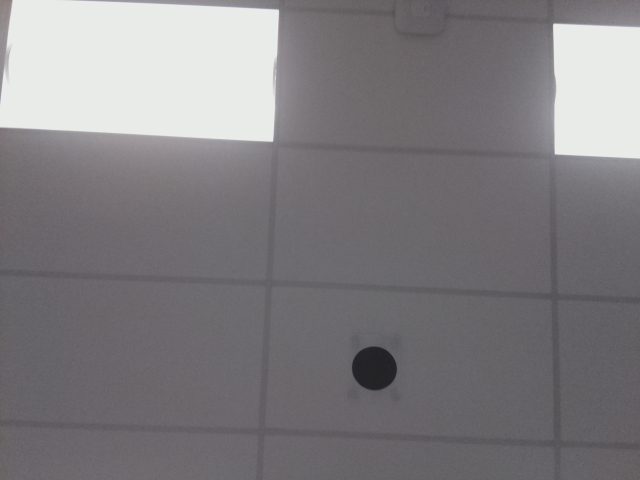
RasberryPi/images/ceiling5.jpg
