Curtis-Milo/Capstone/RasberryPi/images/ceiling6.jpg

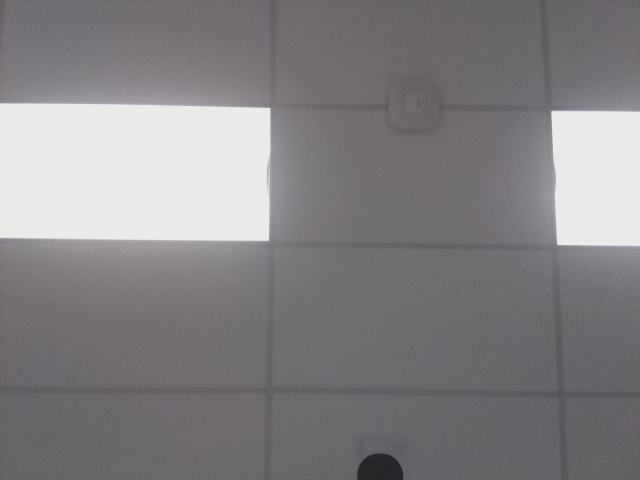
RasberryPi/images/ceiling6.jpg
