Curtis-Milo/Capstone/RasberryPi/images/ceiling7.jpg

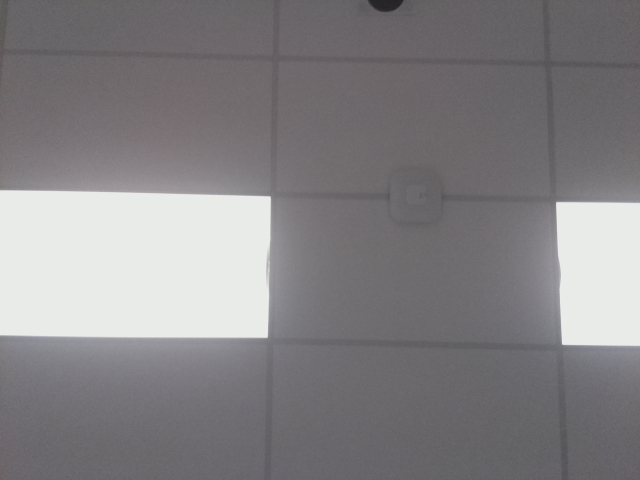
RasberryPi/images/ceiling7.jpg
