Curtis-Milo/Capstone/RasberryPi/images/ceiling9.jpg

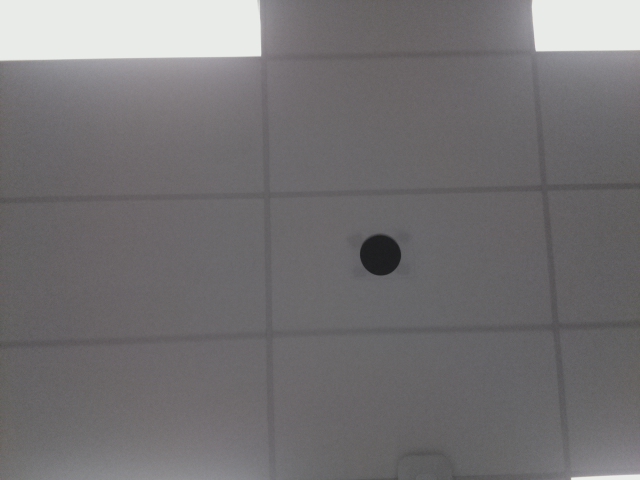
RasberryPi/images/ceiling9.jpg
