Curtis-Milo/Capstone/RasberryPi/images/ceiling10.jpg

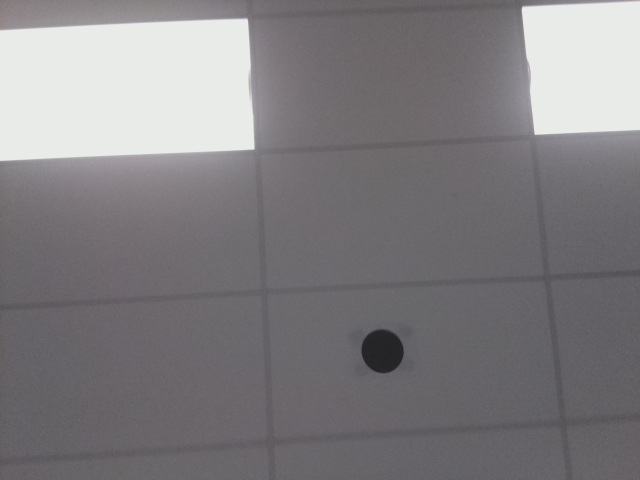
RasberryPi/images/ceiling10.jpg
