Curtis-Milo/Capstone/RasberryPi/images/ceiling11.jpg

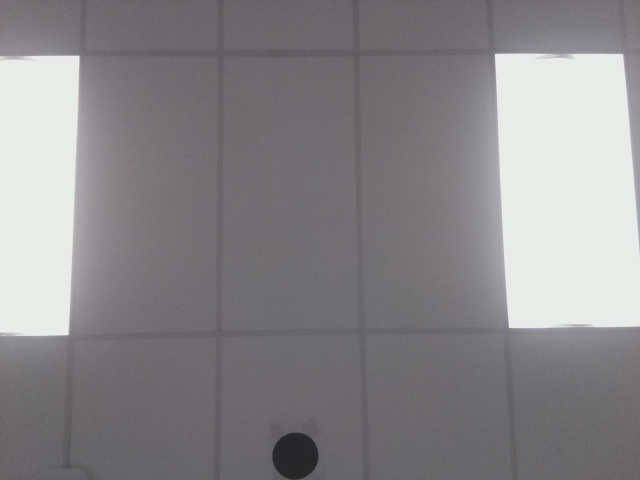
RasberryPi/images/ceiling11.jpg
