Curtis-Milo/Capstone/RasberryPi/images/ceiling12.jpg

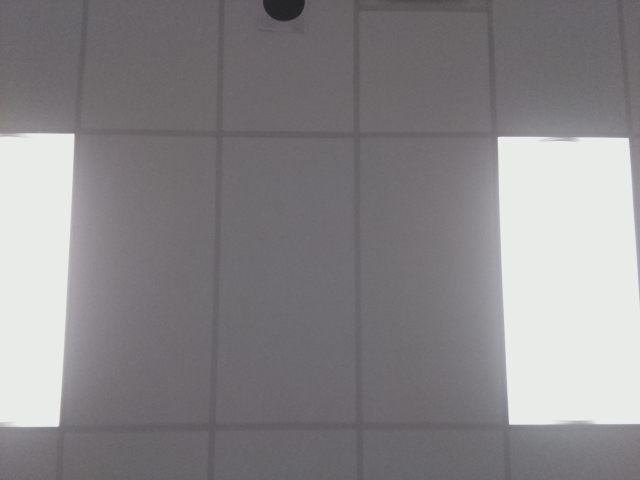
RasberryPi/images/ceiling12.jpg
