Curtis-Milo/Capstone/RasberryPi/images/ceiling13.jpg

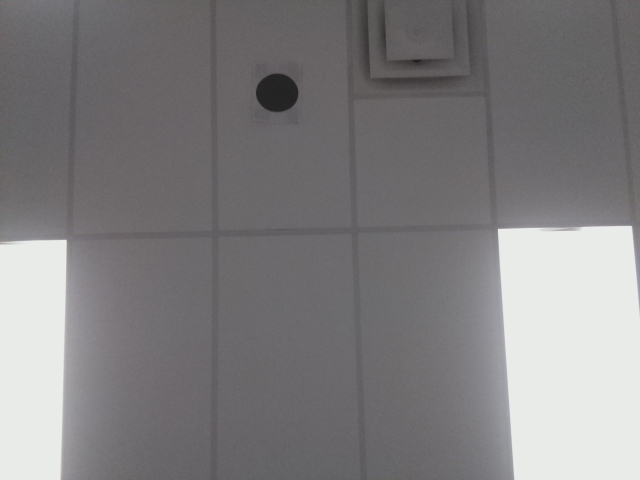
RasberryPi/images/ceiling13.jpg
