Curtis-Milo/Capstone/Documentation/Cost/Cost of items.xlsx

Sheet: Marko
Item | price | Bought by | Date
Stacking header pins | 12.99 | Marko | Oct 16,2017 | Total: | 1731.62
Raspberry and SD card | 71.3 | Marko | Sep 29,2017 | Per person | 288.6033333
12V 2A power supply | 13.99 | Marko | Oct 12,2017
Stepper motor Hat | 41.8 | Marko | Oct 11,2017
Wires | 17.99 | Marko | Oct 8,2017
Encoders | 19.98 | Marko | Oct 6,2017
jumper cables | 10.99 | Marko | Oct 6,2017
couplings | 10.73 | Marko | Oct 6,2017
voltage regulator + batteries | 28.27 | Marko | Oct 5,2017
motor drivers | 18.96 | Marko | Oct 5,2017
ultrasonic sensors | 13.86 | Marko | Oct 5,2017
motors | 37.98 | Marko | Oct 4,2017
pi camera | 35.02 | Marko | Oct 4,2017
Screws and L brackets | 68.84 | Marko | Jan 16,2018
set screws | 18.42 | Marko | Jan 29,2018
Wheels | 17.48 | Marko | Jan 18,2018
Wheel | 10.72 | Marko | Jan 10,2018
L brackets | 44.75 | Marko | Jan 17,2018
superglue and plastic box (POC) | 25.96 | Marko | Nov,15,2017
POC wheels, nuts, screws, l brackets | 130.19 | Marko | Oct 12,2017
MDF | 5.31 | Marko | Oct 13,2017
Nuts | 3.94 | Marko | Jan 22,2018
3/8 nuts, bolts | 29.5 | Marko | jan 15,2017
POC wheels first batch | 64.55 | Marko | Nov 11,2017
POC wheels v2 and nuts | 39.34 | Marko | Nov 11,2017
POC shaft supports | 11.57 | Marko | Nov 14,2017
5mm rubber pipe for rigid couplings | 11.5 | Marko | Nov 14,2017
Stepper motor driver | 9.48 | Marko | Nov 13,2017
POC 12V battery pack | 46.99 | Marko | Nov 9,2017
Flex couplings | 10.73 | Marko | Nov 4,2017
H bridge | 34.59 | Marko | Nov 30,2017
Drill motors | 100 | Marko | N/A
Raspberry pi | 97.34 | Marko | Mar 14,2018
16Gb Micro SD card | 10.99 | Marko | N/A
32GB Micro SD Card | 14.99 | Marko | N/A
Encoders | 29.97 | Marko | Jan 31,2018
Chain link connectors | 4.46 | Marko | jan 19,2018
Chain and chain breaker | 50.61 | Marko | Jan 17,2018
3 rolls of 3D filament | 90 | Marko | N/A
Sprockets | 51.75 | Marko | Feb 27,2018
Couplings (robot shop) | 15.39 | Marko | Jan 10,2018
Ball bearings | 30 | Marko | N/A
Couplings (robot shop) | 15.81 | Marko | Dec 18,2017
Shaft coupling and optical encoder | 31.83 | Marko | Dec 9,2017
Poly carbonate | 168.79 | Marko | Jan 12,2018
H bridge | 67.98 | Marko | Mar 14,2018
H bridge | 33.99 | Marko | Mar 16,2018

Sheet: Curtis
Item | price | Bought by | Date
3x Encoders | 30 | Curtis | 2018-03-17 | Total: | 420.65
Flex Cable, Camera extension line, 100cm | 13.98 | Curtis | 2018-02-14 | Per person | 70.10833333
Raspberry Pi 3 Model B Motherboard | 55.21 | Curtis | 2018-01-22
MALIDA Tee 3/8" x 3/8" x 3/8" quick connect for RO water system (5 pack) | 12 | Curtis | 2018-01-12
Battery for pi | 12 | Curtis | 2017-11-17
Generic Push in Quick Touch to Connect Fitting 1/4" | 11 | Curtis | 2017-12-20
Bread board/ wires | 55 | Curtis | 2017-10-22
3 Pumps | 36 | Curtis | 2017-10-11
20 AWG 300V coper Wire | 22 | Curtis | 2017-10-04
Containers | 29.04 | Curtis | 2017-10-03
MOSFETs | 8.68 | Curtis | 2017-10-03
1/4" Tubing | 20.77 | Curtis | 2017-09-28
temperature sensor waterproof probe wirre | 6.8 | Curtis | 2017-11-11
Weight Sensors | 5 | Curtis | 2017-11-02
Load Cell amplifier | 53.17 | Curtis | 2018-02-18
Robot Shop Couplers | 40 | Curtis | 1/22/18
MDF Board | 10 | Curtis | 2018-03-17

Sheet: Alex
Item | price | Bought by | Date
Canadian Tire Stuff | 45.8 | Alex |  | Total: | 45.8
 |  | Alex |  | Per person | 7.633333333

Sheet: Keyur
Item | price | Bought by | Date
Set Screws | 12.62 | Keyur |  | Total: | 12.62
 |  |  |  | Per person | 2.103333333
