Curtis-Milo/Capstone/Documentation/7-Component_Design/main.tex

% Document uses 12 pt font
% 1 in margins
% Contains a relative path for images

\documentclass [10pt]{article}

% page geometry 
\usepackage[margin=1in]{geometry}

% ----------  PACKAGES START ------------ %
% Math Packages
\usepackage{amsmath}
\usepackage{mathtools}

% Table cell color package and highlighting
\usepackage[table]{xcolor}
\usepackage{color,soul}

% VIC title package\
\usepackage[T1]{fontenc}

% default font package
%\usepackage{times}
\usepackage{helvet}
%\renewcommand{\familydefault}{\sfdefault}

% ---------- End Font Packages -------------- %

%\usepackage{listings}

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

% List package
\usepackage{enumitem}
\setenumerate{itemsep=0pt, itemindent=0in,leftmargin=0.5in}

% Paragraph parameter

\setlength{\parindent}{0pt}

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

% ------------- Creates a click-able Table of Contents  End--------------- %

% ---------- PACKAGES END ------------ %

% -------- SECTION AND SUBSECTION FORMATING START -------- % 
% starts the 
%\setcounter{section}{1}

\titleformat{\section} % Section
{\normalfont \fontsize{14}{14} \bfseries}{}{0em}{\colorsection}

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

% Makes a background color
\titleformat{\subsection} % Subsection
{\normalfont \fontsize{12}{12}  \bfseries}{}{0em}{\colorsubsection }

\newcommand{\colorsubsection}[1]{%
  \colorbox{subsectionC}{\parbox{\dimexpr \textwidth -1\fboxsep}{\large\thesubsection\ #1}}}

% Makes a background color
\titleformat{\subsubsection} % Subsubsection
{\normalfont \fontsize{12}{12} \bfseries}{}{0em}{\colorsubsubsection}

\newcommand{\colorsubsubsection}[1]{%
  \colorbox{subsubsectionC}{\parbox{\dimexpr\textwidth-1\fboxsep}{\thesubsubsection\ #1}}}

% -------- SECTION AND SUBSECTION FORMATING END -------- % 
\usepackage{lipsum}

% -----  IMAGE PATH START -----%
% Relative Image Path
\graphicspath {figures/}
% -----  IMAGE PATH END -----%

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

%------------------------------TOC FORMAT START --------------------------------%
\usepackage{tocloft}

% Section indentations
\cftsetindents{section}{0em}{1.5em}
\cftsetindents{subsection}{1em}{2em}
\cftsetindents{subsubsection}{2em}{3em}

% Toc title size
\renewcommand\cfttoctitlefont{\Large\bfseries}
\renewcommand*\contentsname{Table of Contents}

\newcommand{\carSpeed}{1.4\ m/s}
\newcommand{\intersectionLength}{0.6\ m}

% Removes bold headings from toc
%\renewcommand{\cftsecfont}{\normalfont}

% Removes bold heading page numbers from toc
\renewcommand{\cftsecpagefont}{\normalfont}

% add dots after headings
%\renewcommand{\cftsecleader}{\cftdotfill{\cftdotsep}} 

% number of section headings we want to see in toc
\setcounter{tocdepth}{2}

% Spaceing before headings in toc
\setlength{\cftbeforesecskip}{6pt}

% ------------------------------TOC FORMAT END --------------------------------%

% ------------------- START HEADER AND FOOTER ---------------------------%
\usepackage{fancyhdr}

% Helps with the n of total n pages
\usepackage{lastpage}

\pagestyle{fancy}

% Header
\lhead{Component Design}
\rhead{Revision: 0}
\fancyhead[LE,CO]{Group 9: LazyBots}

% Removes line under the header 
\renewcommand{\headrulewidth}{0pt}
\setlength{\headsep}{.2in}

% Footer 

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

% ------------------- END HEADER AND FOOTER ---------------------------%

% -------------- DOCUMENT START ---------------%
\begin{document}

% --------- TITLE PAGE START ------- %
\begin {center} 

\thispagestyle{empty}
\vspace*{5cm}

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

\Huge{LazyBots}

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

{\large \textsc{Group 9} \\} \vspace{1cm}

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

\end{center}

% --------- TITLE PAGE END------- %

\pagebreak

% Inserting table of contents and table of figures 

\tableofcontents
\listoftables
\listoffigures

\pagebreak

% -----------  REVISION HISTORY START ----------- %

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

\end{longtable}

\pagebreak

%---------------------------- PROJECT DRIVERS ------------------------%
% heading in document

% -------------- START INTRODUCTION ---------------- %

\section {ClientApp}

\subsection{Purpose}

\subsection{Scope}

\subsection{Module Decomposition}

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

\textbf{Activity\_DrinksList}: GUI class for users to go through available drinks and choose their order. Secrets include parsing drink info coming from the server.
\textbf{Activity\_OrderCart}: GUI class for users to view their current cart, as well as their previous orders. Secrets include parsing and dealing with server’s response when order is sent to the server.

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

\textbf{DrinkOrder}: Object class representing a table’s order to be sent to the server. 
\textbf{NetworkCalls}: Asynchronous class to perform network calls for the client app. Secrets include how network requests/responses are handled.

\subsection{Uses Relation}

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

\subsection{MIS}

\subsubsection{Drink}

\textbf{Uses} : None

\textbf{Public Functions}

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

\textbf{setAmount(int amt):void}
Sets the number of drinks of this type in the cart.

\textbf{getName():String}
Returns the name of the drink.

\textbf{getCalories():int}
Returns the amount of calories for the restaurant’s serving size.

\textbf{getImage():int}
Returns the id number for the image of this drink type.

\textbf{getPrice():double}
Returns the price of this drink.

\textbf{getPriceForAmount():double}
Returns the total price of the amount of this drink.

\textbf{getAmount():int}
Returns the amount of the drink currently in the cart.

\subsubsection{DrinkOrder}

\textbf{Uses} : None

\textbf{Public Functions}

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

\subsubsection{Activity\_DrinksList}

\textbf{Uses}

\begin{itemize}
	\item DrinksViewAdapter (Class)
	\item NetworkCalls (Class)
\end{itemize}

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

\subsubsection{Activity\_Login}

\textbf{Uses}
\begin{itemize}
	\item NetworkCalls (Class)
\end{itemize}

\textbf{Public Functions}

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

\textbf{onCreate(Bundle savedInstanceState):void}
Initialize this Activity(app menu) when created.

\subsubsection{Activity\_Settings}

\textbf{Uses}
\begin{itemize}
	\item NetworkCalls (Class)
\end{itemize}

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

\textbf{onCreate(Bundle savedInstanceState):void}
Initialize this Activity(app menu) when created.

\subsubsection{Activity\_OrderCart}

\textbf{Uses}
\begin{itemize}
	\item DrinkCartListAdapter (Class)
	\item NetworkCalls (Class)
\end{itemize}

\textbf{Public Functions}

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

\textbf{onCreate(Bundle savedInstanceState):void}
Initialize this Activity(app menu) when created.

\subsubsection{NetworkCalls}
\textbf{Uses}:None

\textbf{Public Functions}

\textbf{NetworkCalls(String api\_key)}
Constructor for NetworkCalls. Takes the api key.

\textbf{doInBackground(String[] strings):Object}
Executes the HTTP request based on the api key provided.

\textbf{onPostExecute(Object result):void}
Processes the response after doInBackground is completed.

\subsubsection{DrinksViewAdapter}

\textbf{Uses}
\begin{itemize}
	\item Drink (Class)
\end{itemize}

\textbf{Public Functions}

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

\textbf{getCount():int}
Returns the amount of items in the list of drinks.

\textbf{getAllItems():ArrayList<Drink>}
Returns the list of drink info.

\textbf{getItem(int position):Object}
Returns the item for the position id passed to it.

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

\subsubsection{DrinkCartListAdapter}
\textbf{Uses} None

\textbf{Public Functions}

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

\textbf{getCount():int}
Returns the amount of items in the cart.

\textbf{getItem(int position):Object}
Returns the item for the position id passed to it.

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

\subsection{MID}

\subsubsection{Drink}

\textbf{Uses} : None

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

\textbf{Functions}

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

\textbf{public getName():String}
Returns the name of the drink.

\textbf{public getCalories():int}
Returns the amount of calories for the restaurant’s serving size.

\textbf{public getImage():int}
Returns the id number for the image of this drink type.

\textbf{public getPrice():double}
Returns the price of this drink.

\textbf{public getAmount():int}
Returns the amount of this drink currently in the cart.

\textbf{public getPriceForAmount():double}
Returns the total price of the amount of this drink.

\subsubsection{DrinkOrder}
\textbf{Uses} : None
\textbf{Internal Variables}
\textbf{order: item[]} - Array of drink items

\textbf{Functions}

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

\subsubsection{Activity\_DrinksList}

\textbf{Uses}

\begin{itemize}
	\item DrinksViewAdapter (Class)
	\item NetworkCalls (Class)
\end{itemize}

\textbf{Internal Variables}
\textbf{gv: GridView} - The view holding the list of drink items

\textbf{Functions}

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

\textbf{public onClickViewCart(View v):void}
Listener for the view cart button. Launches Activity\_OrderCart.

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

\textbf{private setUpCurrentCart():ArrayList<Drink>}
Retrieves and returns the items stored in gv.

\subsubsection{Activity\_Login}

\textbf{Uses}

\begin{itemize}
	\item NetworkCalls (Class)
\end{itemize}

\textbf{Internal Variables} None

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

\subsubsection{Activity\_Settings}

\textbf{Uses}
\begin{itemize}
	\item NetworkCalls (Class)
\end{itemize}

\textbf{Internal Variables}
\textbf{tableNum: int} - The table number associated with this device.

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

\subsubsection{Activity\_OrderCart}

\textbf{Uses}

\begin{itemize}
	\item DrinkCartListAdapter (Class)
	\item NetworkCalls (Class)
\end{itemize}

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

\textbf{protected onCreate(Bundle savedInstanceState):void}
Initialize this Activity(app menu) when created.

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

\subsubsection{NetworkCalls}

\textbf{Uses}:None

\textbf{Internal Variables}

\textbf{api\_key: String} - String representing the api being targeted. Used for conditionals.

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

\textbf{Functions}

\textbf{public NetworkCalls(String api\_key)}
Constructor for NetworkCalls. Takes the api key.

\textbf{public doInBackground(String[] strings):Object}
Executes the HTTP request based on the api key provided.

\textbf{public onPostExecute(Object result):void}
Processes the response after doInBackground is completed.

\subsubsection{DrinksViewAdapter}

\textbf{Uses}

\begin{itemize}
	\item Drink (Class)
\end{itemize}

\textbf{Internal Variables}

\textbf{drinks: ArrayList<Drink>} - ArrayList of Drink objects representing the current cart selections.

\textbf{Functions}

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

\textbf{public getCount():int}
Returns the amount of items in the list of drinks.

\textbf{public getAllItems():ArrayList<Drink>}
Returns the list of drink info.

\textbf{public getItem(int position):Object}
Returns the item for the position id passed to it.

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

\subsubsection{DrinkCartListAdapter}

\textbf{Uses} None

\textbf{Internal Variables}
\textbf{currentCart: ArrayList<String[]>} - ArrayList of Drink objects representing the current cart selections.

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

\textbf{public getCount():int}
Returns the amount of items in the cart.

\textbf{public getItem(int position):Object}
Returns the item for the position id passed to it.

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

\section {Manager System}

\subsection{Purpose}
The following will describe the component software design associated with Manager System. This will be carried out within web based tools to allow managment to access there information Anywhere

\subsection{Scope}

The scope of this section is associated with any front end user interfaces that the managment staff will use. This includes the MIS/MID and uses relation in regards to the Map Making Page, the Error Viewing page and the Login System. 

\subsection{Module Decomposition}

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

\subsection{Uses Relation}

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

\subsection{MIS}

\subsubsection{Login Page}
\textbf{Uses}
\begin{itemize}
	\item MapMaking (WebPage)
	\item ErrorViewer (WebPage)
\end{itemize}

\textbf{Public Functions}

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

\subsubsection{MapMaking Page}
\textbf{Uses}
None

\textbf{Public Functions}

\textbf{ Map(length:Int, width:Int): void}
Constructor to object for page load

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

\subsubsection{ErrorViewer Page}
\textbf{Uses}
None

\textbf{Public Functions}

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

\subsection{MID}

\subsubsection{Login Page}
\textbf{Uses}
\begin{itemize}
	\item MapMaking (WebPage)
	\item ErrorViewer (WebPage)
\end{itemize}

\textbf{Internal Variables}

\textbf{token: String} - Token for a session with the server.

\textbf{Functions}

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

\subsubsection{MapMaking Page}
\textbf{Uses}
None

\textbf{Internal Variables}

\textbf{length: Integer} - Length of the Map

\textbf{width: Integer} - Width of the Map

\textbf{MapData: String[][]}- Storage of the map values

\textbf{Public Functions}

\textbf{public Map(length:Int, width:Int): void}

Constructor to object for page load

\textbf{public onLengthChange(int Length)}

Sets the length of the map when the user changes it in the form.

\textbf{public onWidthChange(int Width)}

Sets the width of the map when the user changes it in the form.

\textbf{setSquare(X:Int, Y:Int, value:Int): void}

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

\subsubsection{ErrorViewer Page}
\textbf{Uses}
None

\textbf{Public Functions}

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

\textbf{onClickReturnHome()}
Signals the Robot to return home.

\section {Alfred System}

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

\subsection{Scope}

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

\subsection{Module Decomposition}

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

\subsection{MIS}

\subsubsection{Alfred Manager Class}

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

\textbf{Public Functions}

\textbf{determineState(): void}

Determines the overall state of Alfred based on the inputs to Alfred. 

\textbf{performAction(): void}

Will preform the desired state based on the state of Alfred.

\subsubsection{Order Class}
\textbf{Uses}
\begin{itemize}
	\item Drink (Enum)
\end{itemize}

\textbf{Public Functions}

\textbf{getDrinks()}

Drink[] - Returns the list of drinks. Based on requirement AF1.

\textbf{getTableNumber}

 Integer - Returns the table number reference. Based on requirement AF3.

\textbf{getTableCoords}

 Integer[] - Returns the coordinates to the table. Based on requirement AF3.

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

\subsubsection{Communication Static Class}
\textbf{Uses}

None 

\textbf{Public Functions}

\textbf{getResturantMap(): String}

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

\textbf{getTableOrder(): Order}

Retrieves and returns the Table's Order. Based on requirement AF3.

\textbf{sendErrors(errors: Integer)}

Sends an integer with the described set of integers. Based on requirement NFR26.

\textbf{transferPump(Order): Integer}

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

\subsubsection{Graph Class}
\textbf{Uses}
\begin{itemize}
	\item Node (Class)
\end{itemize}

\textbf{Public Functions}

\textbf{Graph(String Filename)}

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

\textbf{getShortestPath(): Node[]}

Returns a list of nodes that describes the shortest way to get to the destination. 

\subsubsection{Node Class}
\textbf{Uses}
None 

\textbf{Public Functions}

\textbf{Node(Int X, Int Y)}

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

\textbf{getX(): integer}

Returns the x coordinate of the node

\textbf{getY(): integer}

Returns the y coordinate of the node

\subsubsection{PI Class}
\textbf{Uses}
None 

\textbf{Public Functions}

\textbf{PI(Ki: Float, Kp: Float)}

Constructor for the PI controller object taking in the Ki and Kp terms

\textbf{regulate(Int ref, Int feedback)}

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

\subsubsection{Imaging Processing Static Class}
\textbf{Uses}
\begin{itemize}
	\item Circle (Class)
\end{itemize}

\textbf{Public Functions}

\textbf{getCirclePositions(): Circle[]}

Gives a list of circles that were within the view of the camera

\subsubsection{Circle Class}

\textbf{Uses}
None

\textbf{Public Functions}

\textbf{Circle(radius, x, y)}

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

\textbf{getX(): Float}

Gives the X position of the circle relative to the image

\textbf{getY(): Float}

Gives the Y position of the circle relative to the image

\textbf{getRadius(): Float}

Gives the radius of the circle

\textbf{setX(X:Float)}

Sets the X position of the circle.

\textbf{setY(Y:Float)}

Sets the Y position of the circle.

\textbf{setRadius(rad : Float)}

Sets the radius of the circle

\subsection{MID}

\subsubsection{Alfred Manager Class}

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

\textbf{Internal Variables}

\textbf{mapPath: String} - The absolute path to the map directory

\textbf{drivetrain: DriveTrain} - An object encapsulates information in regards to the drivetrain

\textbf{currentState: State} - Holds the information in regards to which action will be preformed by Alfred

\textbf{Functions}

\textbf{public determineState(): void}

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

\textbf{public performAction(): void}

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

\textbf{Internal Variables}

\textbf{tableNum: Integer} - the reference to the table

\textbf{drinks: Drink[]} - List of drinks for the user's table

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

\textbf{tablePath: String} - gives the path of the table for the hashmap 

\textbf{Functions}

\textbf{public getDrinks(): Drink[]}

Returns the list of drinks

\textbf{public getTableNumber: Integer}

Returns the table number reference

\textbf{public getTableCoords: Integer[]}

Returns the coordinates to the table from the Hashmap of table numbers

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

\textbf{Internal Variables}
\textbf{mapPath: String} - The absolute path to the map directory

\textbf{tableorder: Order} - The order from the next table.

\textbf{ultraSonicPins: Int[]} - The pins dedicated for the ultrasonic sensors

\textbf{hBridgePins: Int[]} - The pins dedicated for the H-bridge

\textbf{graph: Graph} - Object to the graph object to find the shortest path

\textbf{piControllerLeft: PI} - Object used for PI control for the left side of the drivetrain

\textbf{piControllerRight: PI} - Object used for PI control for the left side of the drivetrain

\textbf{Functions}

\textbf{public driveToTable(Order): Integer}

This function will preform the driving operation in order to navigate towards the specific table.

\textbf{private turn(degree: Integer): void}

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

\textbf{private driveForward(void): void}

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

\textbf{private pathwayClear (void): boolean}

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

\subsubsection{Communication Static Class}
\textbf{Uses}
None 
\textbf{Internal Variables}

None 

\textbf{Functions}

\textbf{getResturantMap(): String}

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

\textbf{getTableOrder(): Order}

Retrieves and returns the Table's Order.

\textbf{sendErrors(errors: Integer)}

 Sends an integer with the described set of integers. 
 
\textbf{transferPump(Order): Integer}

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

\subsubsection{Graph Class}
\textbf{Uses}
\begin{itemize}
	\item Node (Class)
\end{itemize}

\textbf{Internal Variables}
None 

\textbf{Functions}

\textbf{Graph(String Filename)}

Constructor to create a graph object. Builds the graph based on the path to the map

\textbf{getShortestPath(): Node[]}

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

\subsubsection{Node Class}
\textbf{Uses}
None 

\textbf{Public Functions}

\textbf{Node(Int X, Int Y)}

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

\textbf{getX(): integer}

Returns the x coordinate of the node.

\textbf{getY(): integer}

Returns the y coordinate of the node.

\textbf{Internal Variables}

\textbf{x: Integer} - The x coordinate of the node

\textbf{y: Integer} - The y coordinate of the node

\textbf{Functions}

\textbf{public Node(Int X, Int Y)}

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

\textbf{public getX(): integer}

Returns the x coordinate of the node

\textbf{public getY(): integer}

Returns the y coordinate of the node

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

\textbf{Functions}

\textbf{public PI(Ki: Float, Kp: Float)}

Constructor for the PI controller object taking in the Ki and Kp terms

\textbf{public regulate(Int ref, Int feedback)}

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

\textbf{Internal Variables}
None

\textbf{Functions}

\textbf{Public getCirclePositions(): Circle[]}

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

\subsubsection{Circle Class}

\textbf{Uses}
None
\textbf{Internal Variables}

\textbf{rad: Float} - The radius of the circle

\textbf{x: Integer} - The X position of the circle relative to the image

\textbf{y: Integer} - The Y position of the circle relative to the image 

\textbf{Functions}

\textbf{Circle(radius, x, y)}

Constructor of the circle class, takes in initial radius, x and y values

\textbf{getX(): Float}

Gives the X position of the circle relative to the image

\textbf{getY(): Float}

Gives the Y position of the circle relative to the image

\textbf{getRadius(): Float}

Gives the radius of the circle

\textbf{setX(X:Float)}

Sets the X position of the circle.

\textbf{setY(Y:Float)}

Sets the Y position of the circle.

\textbf{setRadius(rad : Float)}

Sets the radius of the circle.

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

\section {Pumping System}

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

\subsection{Module Decomposition}

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

\subsection{MIS}

\subsubsection{Main Class}

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

\textbf{Internal Variables}
None

\textbf{Functions}

\textbf{public setup(): void}

Setup function for Arduino that initializes the pins that will be used 

\textbf{publicloop(): void}

Main loop that will preform the main logic of the pumping system

\textbf{public determineState(): void}

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

\textbf{public performAction(): void}

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

\subsubsection{Class Pump}

\textbf{Uses}

\begin{itemize}
	\item DrinkCals
\end{itemize}

\textbf{public Functions}

\textbf{Pump():void}

Initializes the values of the pumping module.

\textbf{pumpLiquid(Drink): Integer}

Turns on the pump for the specific drink type. Based on requirement AF1.

\textbf{stopPump(Drink): Integer}

Turns off the pump for the specific drink type. Based on requirement AF5.

\textbf{isComplete(): Boolean}

Determines if the drink has been completely filled or not based. Based on requirement AF5.

\textbf{isLeaking(): Boolean}

Determines if the containers are losing fluid when there is no pumping. Based on requirement NFR22.

\textbf{isSafeTempature()}

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

\subsubsection{Communication Class}

\textbf{Uses}

\begin{itemize}
	\item DrinkCals
\end{itemize}

\textbf{Internal Values}
None

\textbf{Functions}

\textbf{transferData(Integer): Order}

Communication performed used  where Orders are received and errors are transferred with the Manager system.

\subsection{MID}

\subsubsection{Main Class}

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

\textbf{Internal Variables}

 None

\textbf{Functions}

\textbf{public setup(): void}

Setup function for Arduino that initializes the pins that will be used 

\textbf{public loop(): void}

Main loop that will preform the main logic of the pumping system

\textbf{public determineState(): void}

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

\textbf{public performAction(): void}

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

\subsubsection{Class Pump}

\textbf{Uses}

\begin{itemize}
	\item DrinkCals
\end{itemize}

\textbf{Internal Values}

\textbf{DrinkCals coke}: Structure holding the calibrations related to Coke products

\textbf{DrinkCals water}: Structure holding the calibrations related to Water

\textbf{Functions}

\textbf{public Pump():void}

Initializes the values of the pumping module.

\textbf{public pumpLiquid(Drink): Integer}

Turns on the pump for the specific drink type.

\textbf{public stopPump(Drink): Integer}

Turns off the pump for the specific drink type.

\textbf{public isComplete(): Boolean}

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

\textbf{public isLeaking(): Boolean}

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

\textbf{public isSafeTempature()}

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

\subsubsection{Communication Class}

\textbf{Uses}

\begin{itemize}
	\item DrinkCals
\end{itemize}

\textbf{Internal Values}
 None

\textbf{Functions}

\textbf{transferData(Integer): Order}

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

\subsubsection{queue}
\textbf{Uses}
\begin{itemize}
	\item locks (External Class)
	\item helper (Class)
\end{itemize}

\textbf{Public Functions}
\textbf{Queue(): void}
Constructor function that creates a new empty queue.

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

\textbf{pop(cb): void}
Pops the first element from the queue.

\textbf{size(): int}
calls the callback function with the current size of the queue.

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

\subsubsection{helper}
\textbf{Uses}
None

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

\textbf{Public Functions}
\textbf{BasicAuthManager(): void}
Constructor function to create the object.

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

\textbf{Public Functions}
\textbf{TokenGen(): void}
Constructor function to create the object with new token.

\textbf{refresh(cb): void}
Updates current token.

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

\textbf{sendToken(host): void}
Will send current token to the 'host' given in the parameters.

\subsubsection{verification}
\textbf{Uses}
\begin{itemize}
	\item helper (Class)
	\item types (Enum)
\end{itemize}

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

\textbf{deleteTable(tableId, cb): void}
Remove a table from the filesystem.

\subsubsection{order}
\textbf{Uses}
\begin{itemize}
	\item locks (External Class)
\end{itemize}

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

\textbf{Functions}
\textbf{main(): void}

\begin{center}
	\begin{tabular}{ |c|c|c| } 
		\hline
		GET & POST & DELETE \\ 
		placeinline & placeorder & cancelorder \\ 
		nextorder & gentoken & drinks \\ 
		checktoken & updatecreds & tables \\ 
		drinks & returntobase &  \\ 
		sizes & login &  \\ 
		numoftanks & errors &  \\ 
		& drinks &  \\ 
		& tables &  \\ 
		\hline
	\end{tabular}
\end{center}

\textbf{Placeinline}
Call checkToken for table authentication
If passed, search queue for order\_id
res.write(placeInLine.toString());
\textbf{Placeorder}
Call checkToken for table authentication
If passed, parse the body of the request
Verify that all data is correct
If correct, push order to queue
\textbf{cancelOrder}
Call checkToken for robot authentication
If passed, delete order from queue for specific order\_id
\textbf{Nextorder}
Call checkToken for robot authentication
If passed, call queue’s pop function
res.write(placeInLine.toString());
\textbf{Gentoken}
Call token refresh function
Send token to robot host
\textbf{Checktoken}
Call checkToken for robot authentication
res.write(JSON.stringify(resp\_auth));
\textbf{Updatecreds}
Call checkAuth for admin authentication
If passed, parse body of request
Call authManager update function to update new user/password combination
\textbf{Login}
Call checkAuth for admin authentication
res.writeHead(200, 'Logged in', {'Content-Type': 'text/html'}); if credentials were authenticated
\textbf{Returntobase}
Call checkAuth for admin authentication
Call returnToBase function to have robot return to the kitchen
\textbf{Sizes}
Print out list of drinks that are available
\textbf{Numoftanks}
Print out maximum number of tanks that the robot can hold
\textbf{Errors}
Call checkToken for robot authentication
If passed, list all error messages thrown by the robot
\textbf{Drinks (GET)}
Print out list of drinks that are available
\textbf{Drinks (POST)}
Call checkAuth for admin authentication
Check that the total number of drink types is not already at the maximum
Parse the body of the request
Lock mutex
Store new drink type and tank number into drinks object and write them to file
Unlock mutex
\textbf{Drinks (DELETE)}
Call checkAuth for admin authentication
If passed, parse body of the request. Lock the mutex
Delete specified drink type from DRINKS object. Write drink type list to file
Unlock the mutex
\textbf{Tables (POST)}
Call checkAuth for admin authentication
If passed, call addTable function
res.write(JSON.stringify({token: token, token\_type: 'bearer'}));
\textbf{Tables (DELETE)}
Call checkAuth for admin authentication
If passed, call deleteTable function

\subsubsection{queue}
\textbf{Uses}
\begin{itemize}
	\item locks (External Class)
	\item helper (Class)
\end{itemize}

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

\textbf{Functions}
\textbf{Queue(): void}
This.queue = []

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

\textbf{pop(cb): void}
Lock queue
element = queue.pop()
Unlock queue
cb(null, element)

\textbf{size(): int}
Return queue.length

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

\subsubsection{helper}
\textbf{Uses}
None

\textbf{Internal Values}
None

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

\textbf{Functions}
\textbf{TokenGen(): void}
\_token = rand-token.generate(32)

\textbf{refresh(cb): void}
mutex.lock()
\_token = rand-token.generate(32)
mutex.unlock()
cb()

\textbf{checkToken(token, cb): void}
mutex.lock()
passed = token == \_token
mutex.unlock()
cb(null, passed)

\textbf{sendToken(host): void}
data = {
	token\_type: ‘bearer’,
	access\_token : \_token
}
unirest.post(host, data)

\subsubsection{verification}
\textbf{Uses}
\begin{itemize}
	\item helper (Class)
	\item types (Enum)
\end{itemize}

\textbf{Internal Values}
None

\textbf{Functions}
\textbf{checkData(data, orderObj, table\_id, cb): void}
order = helper.caseInsensitiveKey(data, ‘order’)
If order missing values or in wrong format
	cb(error)

orders = []

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

If no orders
	Return cb(‘no valid orders’)

orderObj.getOrderNum(function(err, order\_id) {
	if (err) {
		return cb(err);
	}
	//return order information
	cb(null, {
		table\_id: table\_id,
		order\_id: order\_id,
		orders: orders
	});
});

\textbf{\_cleanRequire(module): Module}
Delete cached data for module
Return require(module)

\textbf{\_jsonVals(obj): Array}
ret = []
For i of Object.keys(obj)
	ret.push(obj[i])
Return ret

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

\textbf{availableTables(cb): void}
Read all files from filesystem
cb(null, files)

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

\subsubsection{order}
\textbf{Uses}
\begin{itemize}
	\item locks (External Class)
\end{itemize}

\textbf{Internal Values}
\begin{itemize}
	\item int order\_id: Current order number.
\end{itemize}

\textbf{Public Functions}
\textbf{Order(): void}
This.order\_id = 0

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

\section {Scheduling}
%https://cloud.smartdraw.com/editor.aspx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
\begin{figure} [h!]
	\centering
	\includegraphics [scale = 0.55] {figures/Alfred_SequenceDiagram.png}
	\caption{Alfred Sequence Diagram}
\end{figure}

\section {Design Notes}

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

\section {Data Dictionary}

\section {References}
\end{document}
