Curtis-Milo/Capstone/CAD_Models/STL/sensor_mount.stl

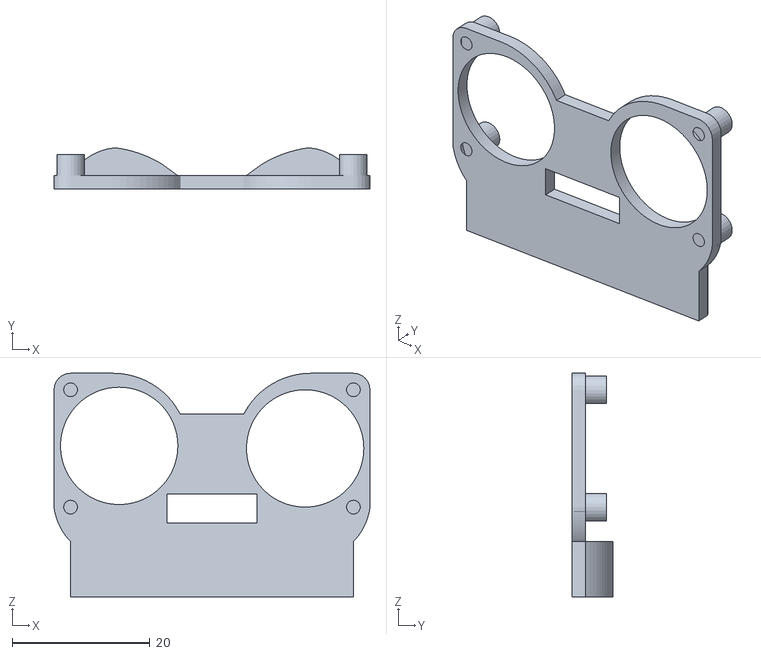
[picture p72: CAD file, 2018-03-07]
CAD_Models/STL/sensor_mount.stl
45.8 x 6.00 x 32.4
