Curtis-Milo/Capstone/CAD_Models/STL/bottom_special.stl

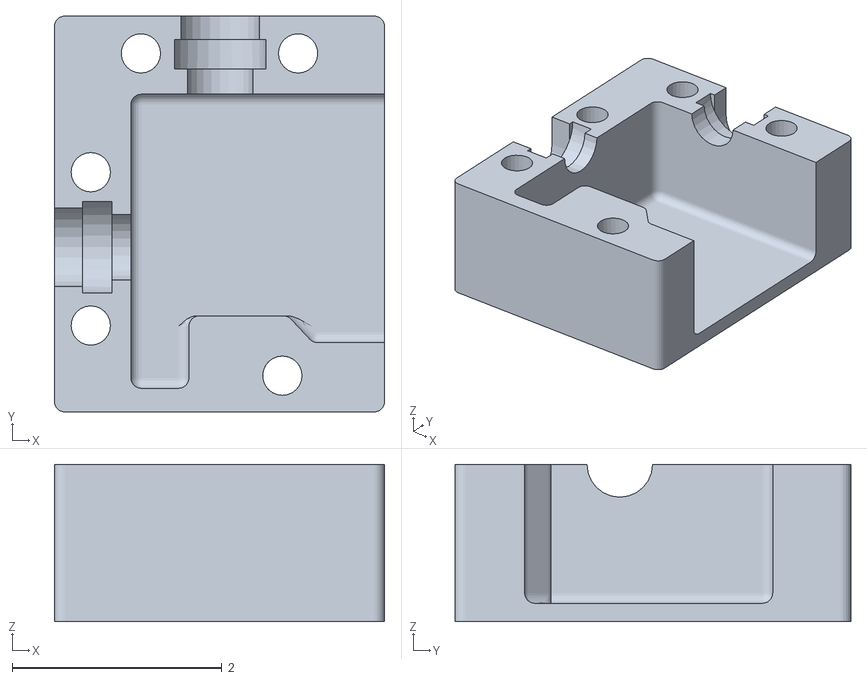
[picture p73: CAD file, 2018-03-06]
CAD_Models/STL/bottom_special.stl
3.15 x 3.78 x 1.50
