Curtis-Milo/Capstone/CAD_Models/STL/top_special.stl

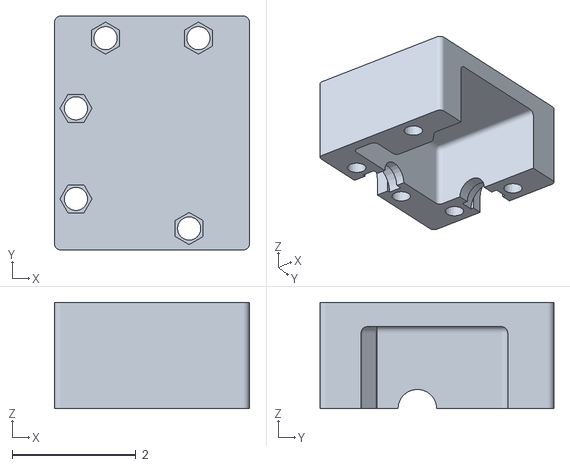
[picture p74: CAD file, 2018-03-06]
CAD_Models/STL/top_special.stl
3.15 x 3.78 x 1.72
