Curtis-Milo/Capstone/CAD_Models/STL/top_gearbox.stl

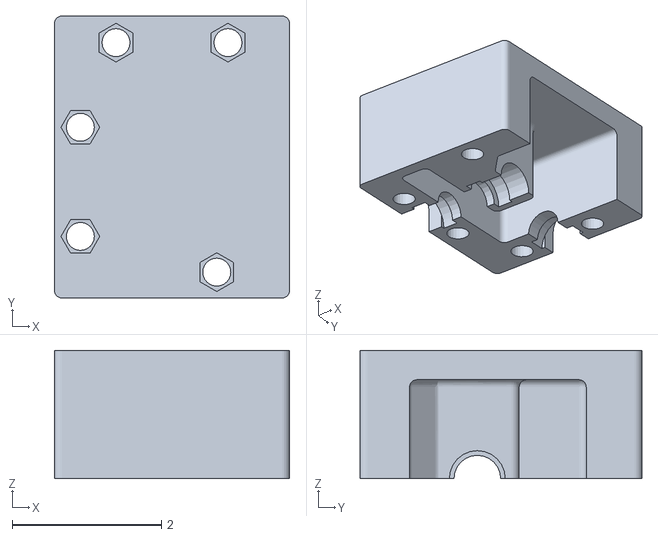
[picture p75: CAD file, 2018-03-06]
CAD_Models/STL/top_gearbox.stl
3.15 x 3.78 x 1.72
