Curtis-Milo/Capstone/CAD_Models/STL/bottom_gearbox.stl

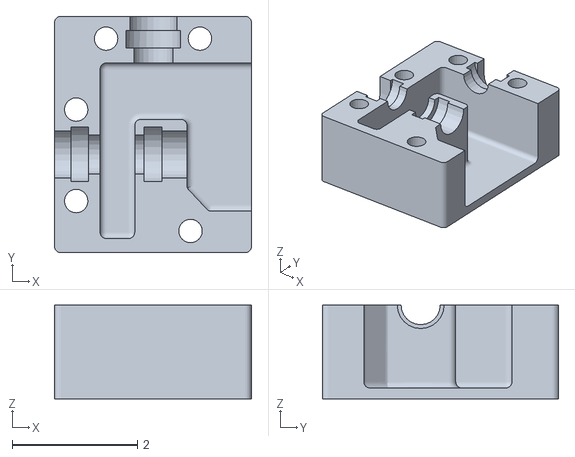
[picture p76: CAD file, 2018-03-06]
CAD_Models/STL/bottom_gearbox.stl
3.15 x 3.78 x 1.50
