Curtis-Milo/Capstone/CAD_Models/STL/UP box 5 .stl

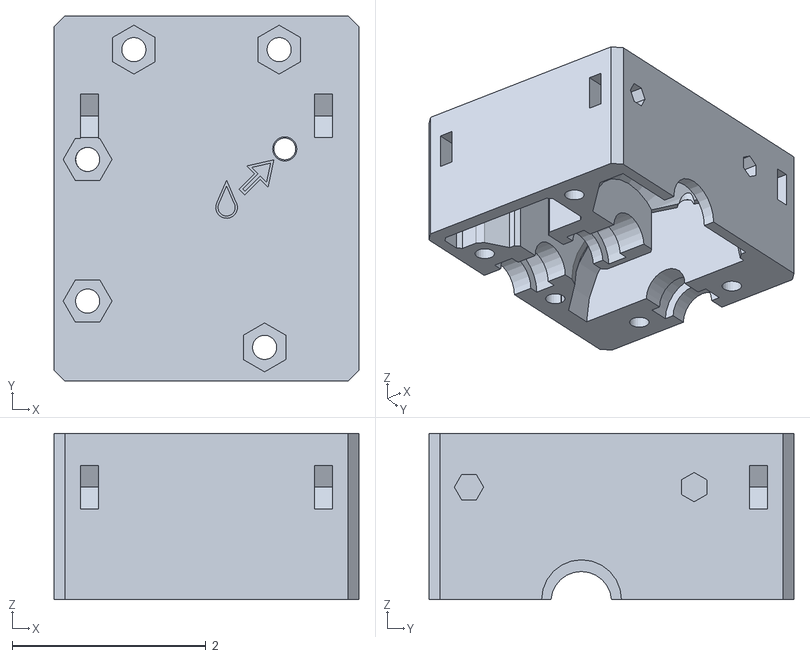
[picture p78: CAD file, 2018-02-27]
CAD_Models/STL/UP box 5 .stl
3.15 x 3.77 x 1.72
