Curtis-Milo/Capstone/(list of files, cad)

Other CAD files:
CAD_Models/Coupler/COUPLER.dwg
CAD_Models/Encoder_Mount/Encoder_Mount_2013.dwg
CAD_Models/gearbox/new_gearbox_2010.dwg
CAD_Models/IG_ALFRED.dwg
CAD_Models/Pump/Pumping_System.dwg
CAD_Models/Alfred_Frame.dwg
CAD_Models/Coupler/COUPLER_IG.dwg
CAD_Models/Encoder_Mount/Encoder_Mount.dwg
CAD_Models/gearbox/gearbox_v3.dwg
CAD_Models/gearbox/gearbox_special_mod.dwg
CAD_Models/gearbox/gearbox.dwg
CAD_Models/Old_Models_Inventor/Base.ipt
CAD_Models/Old_Models_Inventor/Box.iam
CAD_Models/Old_Models_Inventor/Front.ipt
CAD_Models/Old_Models_Inventor/Long_Shaft.ipt
CAD_Models/Old_Models_Inventor/Short_Shaft.ipt
CAD_Models/Old_Models_Inventor/Side.ipt
CAD_Models/Old_Models_Inventor/inner_wall.ipt
