Curtis-Milo/Capstone/Documentation/10-Design_Doc/figures/CAD_GB_Assembly.png

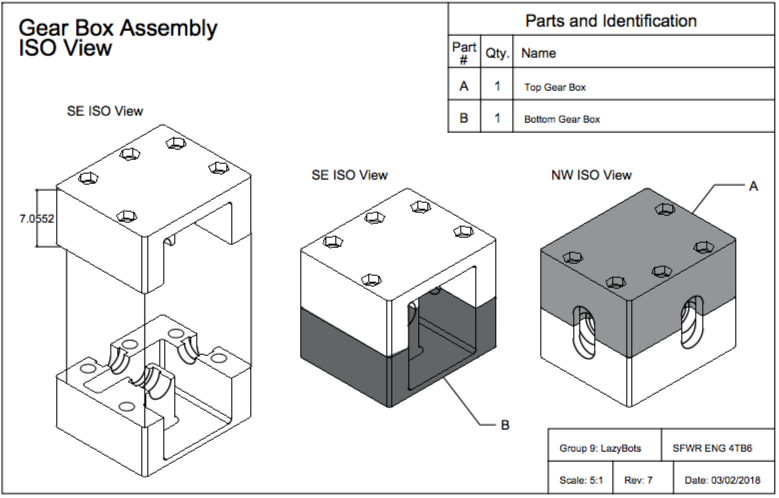
Documentation/10-Design_Doc/figures/CAD_GB_Assembly.png
