Curtis-Milo/Capstone/Documentation/6-Hazard_Analysis/figures/FMEA_2.png

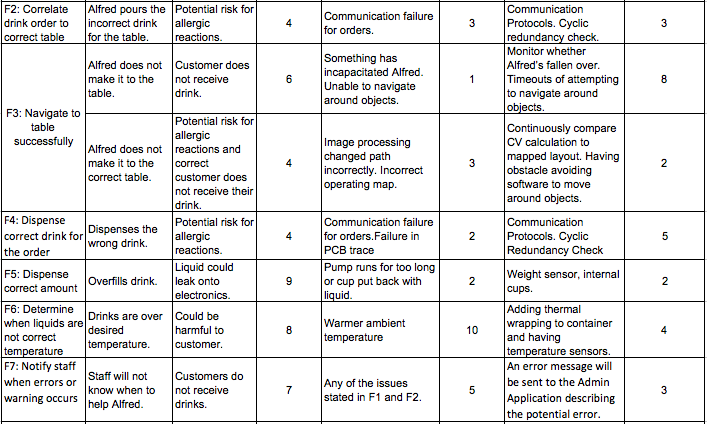
Documentation/6-Hazard_Analysis/figures/FMEA_2.png
