Curtis-Milo/Capstone/Documentation/6-Hazard_Analysis/figures/FMEA_3.png

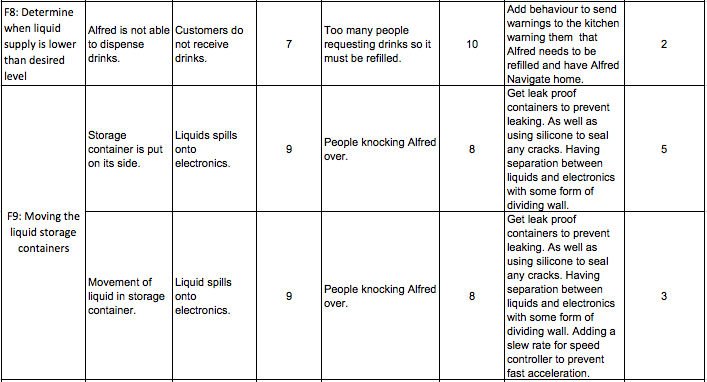
Documentation/6-Hazard_Analysis/figures/FMEA_3.png
