Curtis-Milo/Capstone/Documentation/10-Design_Doc/CAD_Model_PDFs/IG_ALFRED_Layout_10.pdf

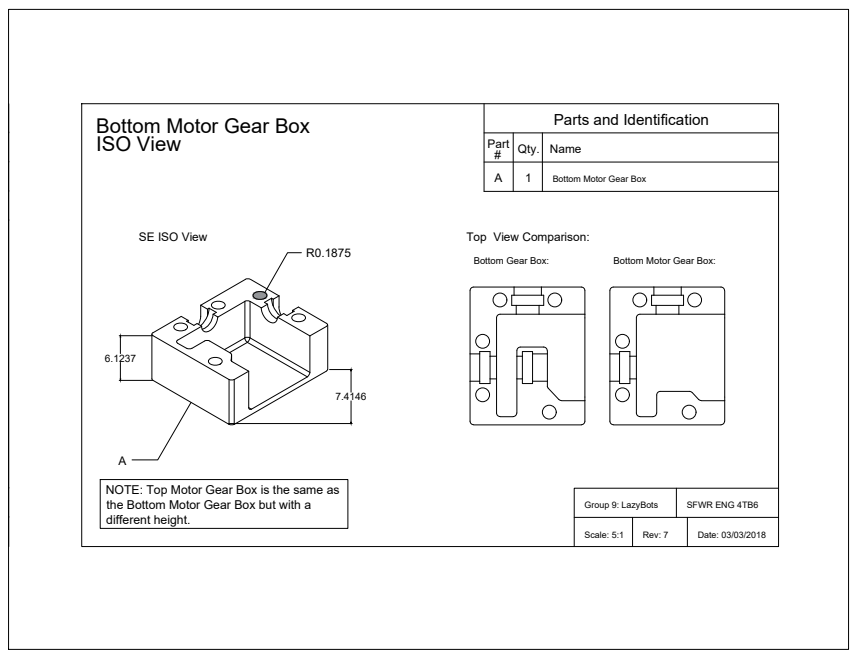
[picture p85: page 1]
Parts and Identification A; 1 Part #; Qty.; Name Bottom Motor Gear Box Scale: 5:1; Rev: 7; Date: 03/03/2018 Group 9: LazyBots; SFWR ENG 4TB6 Bottom Motor Gear Box ISO View SE ISO View 6.1237; 7.4146 R0.1875 NOTE: Top Motor Gear Box is the same as the Bottom Motor Gear Box but with a different height.; Top View Comparison: Bottom Gear Box:; Bottom Motor Gear Box: A
