Curtis-Milo/Capstone/Documentation/10-Design_Doc/CAD_Model_PDFs/IG_ALFRED_Layout_11.pdf

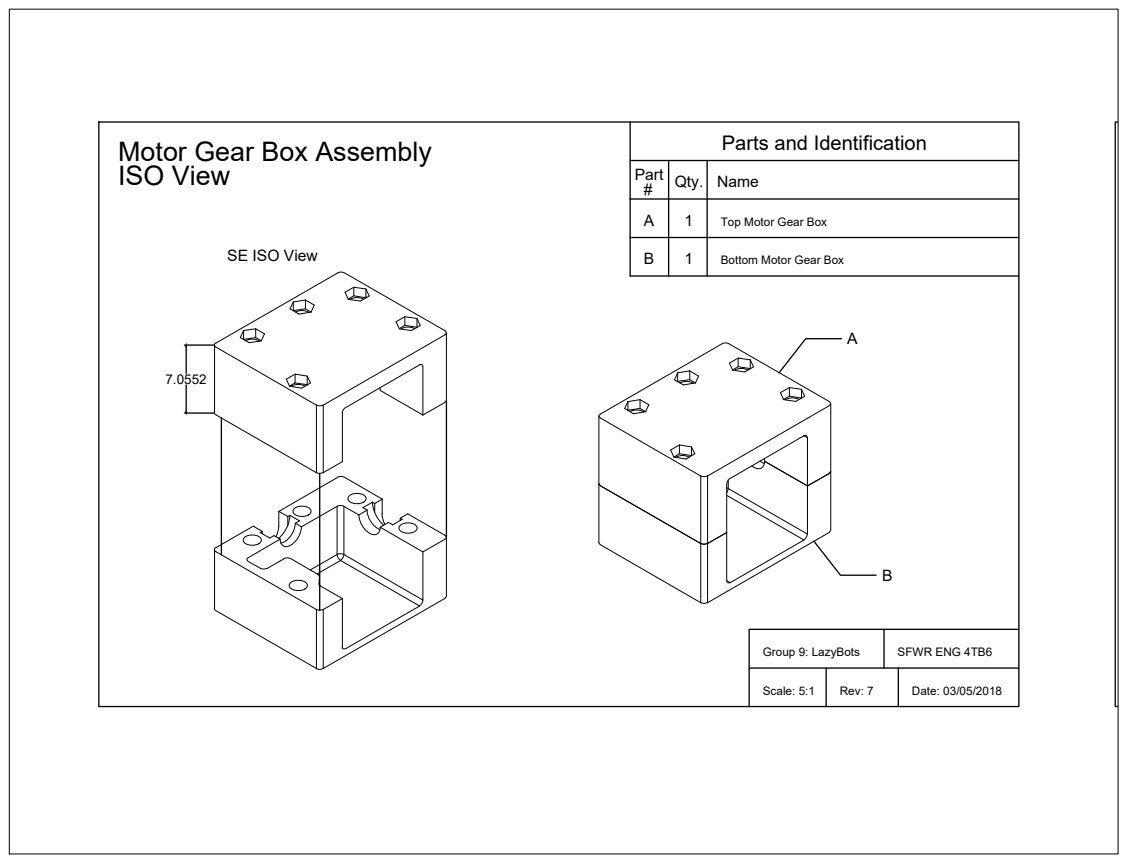
[picture p86: page 1]
Motor Gear Box Assembly ISO View; Parts and Identification A; 1 Part #; Qty.; Name Top Motor Gear Box Scale: 5:1; Rev: 7; Date: 03/05/2018 Group 9: LazyBots; SFWR ENG 4TB6 SE ISO View 7.0552; Bottom Motor Gear Box
