Curtis-Milo/Capstone/Documentation/10-Design_Doc/CAD_Model_PDFs/IG_ALFRED_Layout_12.pdf

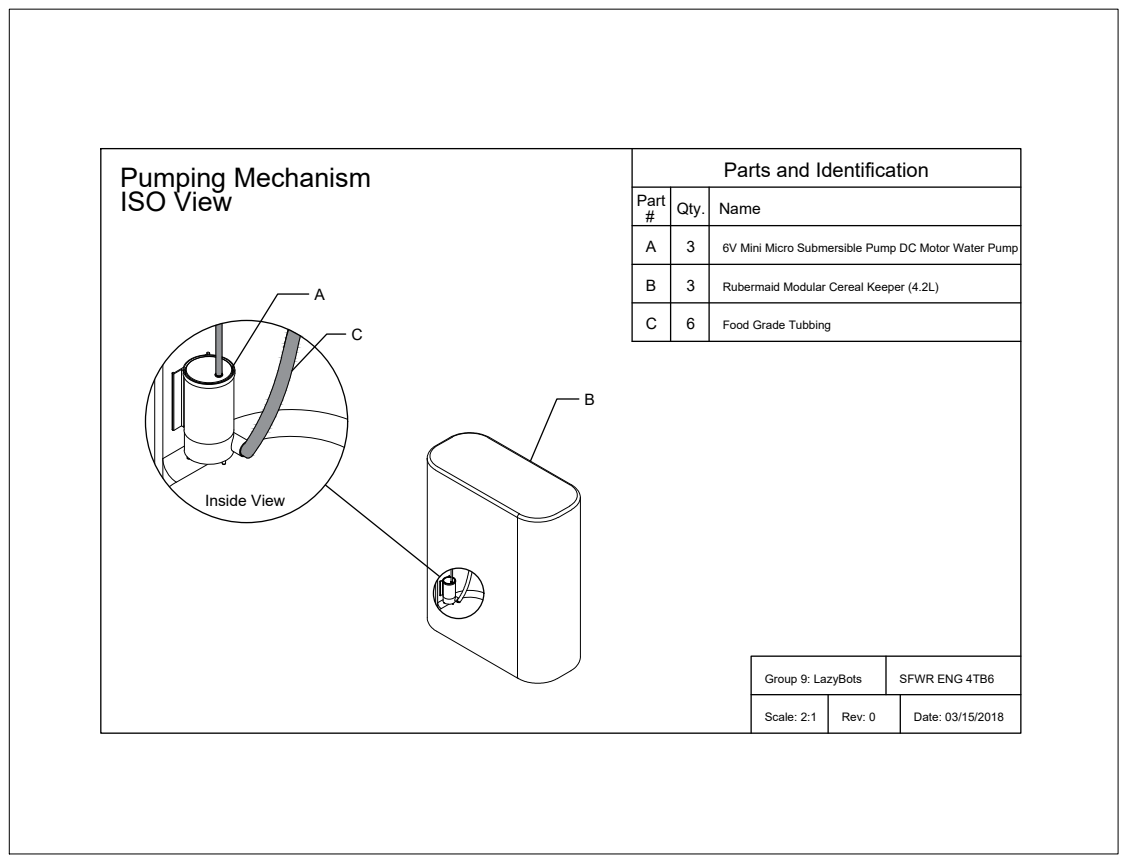
[picture p87: page 1]
Pumping Mechanism ISO View; Parts and Identification A; 3 Part #; Qty.; Name 6V Mini Micro Submersible Pump DC Motor Water Pump Scale: 2:1; Rev: 0; Date: 03/15/2018 Group 9: LazyBots; SFWR ENG 4TB6 B; Food Grade Tubbing Rubermaid Modular Cereal Keeper (4.2L) Inside View
