Curtis-Milo/Capstone/Documentation/10-Design_Doc/CAD_Model_PDFs/IG_ALFRED_Layout_8.pdf

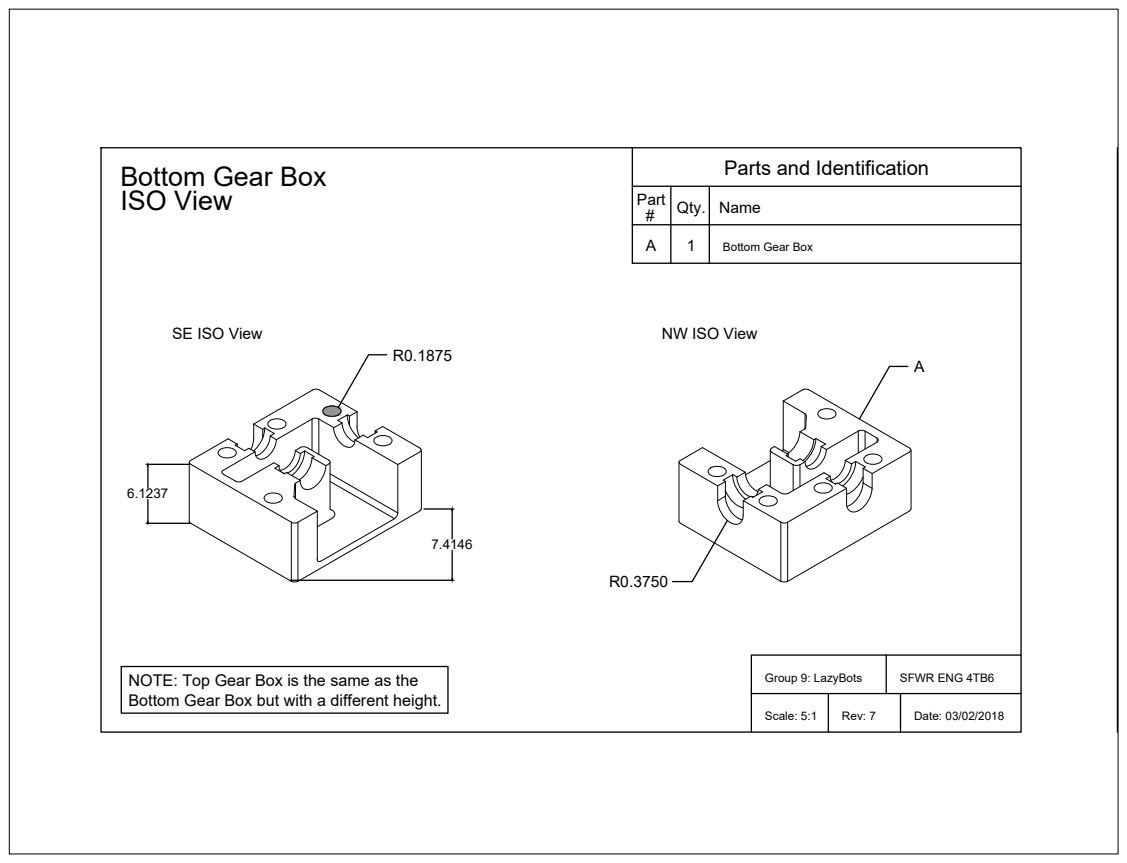
[picture p88: page 1]
Bottom Gear Box ISO View; Parts and Identification A; 1 Part #; Qty.; Name Bottom Gear Box Scale: 5:1; Rev: 7; Date: 03/02/2018 Group 9: LazyBots; SFWR ENG 4TB6 SE ISO View; NW ISO View 6.1237; A NOTE: Top Gear Box is the same as the Bottom Gear Box but with a different height.
