Curtis-Milo/Capstone/Documentation/10-Design_Doc/CAD_Model_PDFs/IG_ALFRED_Layout_9.pdf

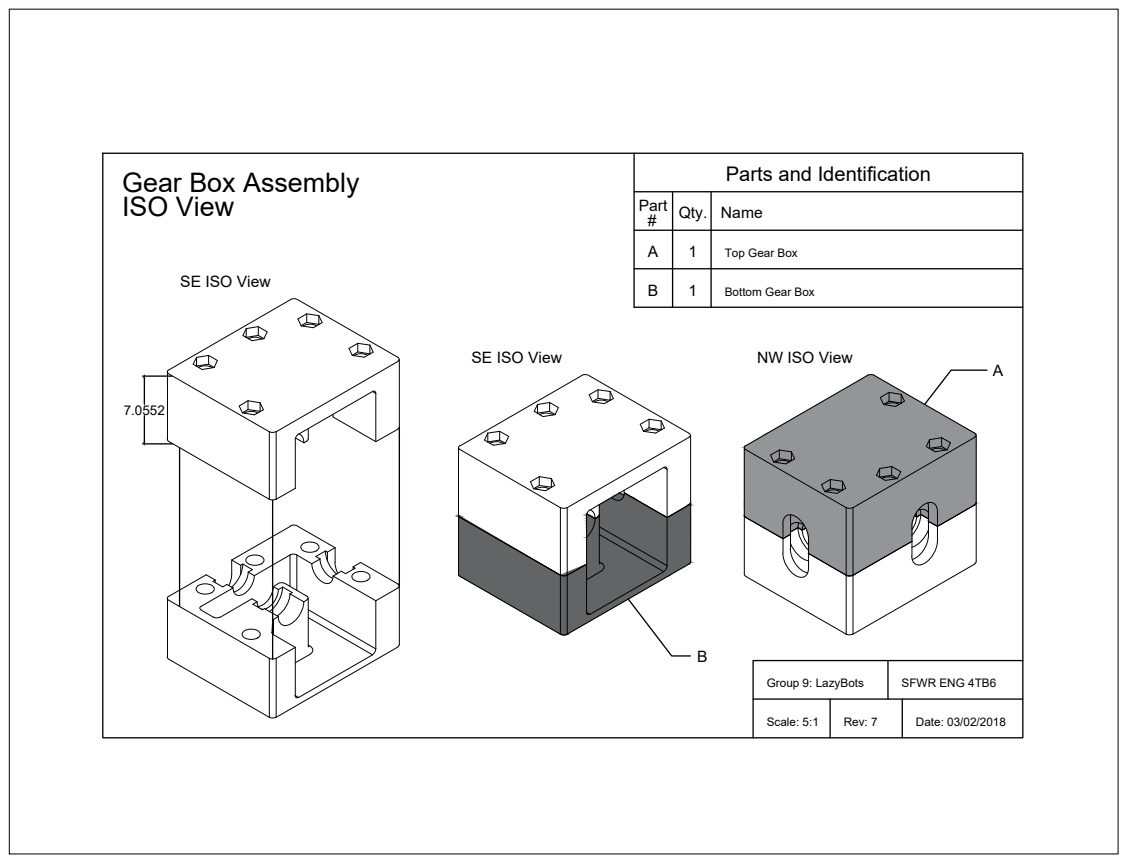
[picture p89: page 1]
Gear Box Assembly ISO View; Parts and Identification A; 1 Part #; Qty.; Name Top Gear Box Scale: 5:1; Rev: 7; Date: 03/02/2018 Group 9: LazyBots; SFWR ENG 4TB6 SE ISO View; SE ISO View; NW ISO View B; Bottom Gear Box B
