Curtis-Milo/Capstone/CAD_Models/Coupler/COUPLER_IG.pdf

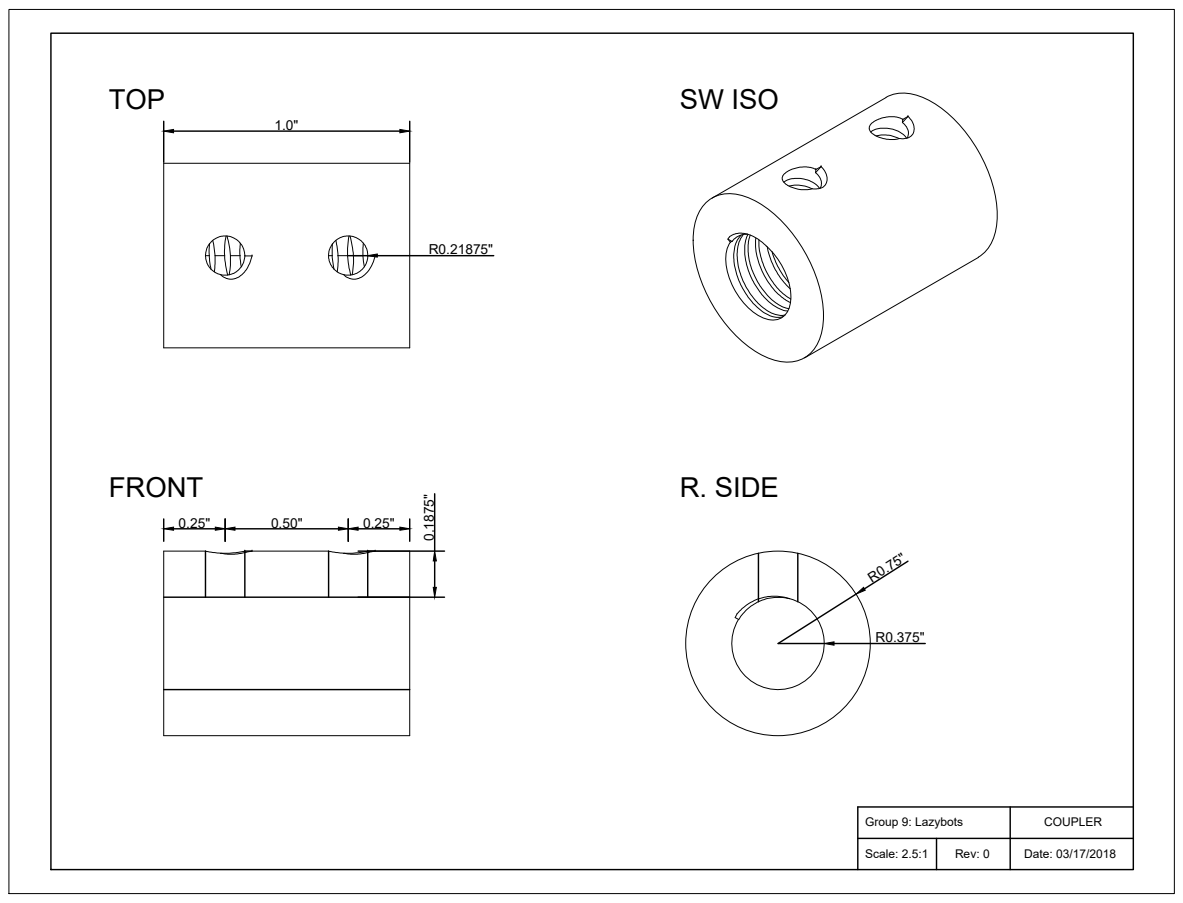
[picture p90: page 1]
TOP FRONT; R. SIDE SW ISO; Scale: 2.5:1; Rev: 0; Date: 03/17/2018 Group 9: Lazybots; COUPLER 1.0"
