Curtis-Milo/Capstone/DrinkMachine/pump/sensors.h

#ifndef _SENSORS_H_
#define _SENSORS_H_

float getTempature(int pin);
float getWeight(int pin);


typedef struct{
  float maxTemp;
  int pinA;
  int pinB;
}TempCals;

typedef struct{
  float minWeight;
  float minCup;
  float timeOut;
}WeightCals;

#endif
