Curtis-Milo/Capstone/(commit log)

2017-11-01 added excel file with cost of all meterials
    [Cost of items.xlsx]
2017-11-01 Adding data flow diagram
2017-11-05 added motor control file
    [Cost of items.xlsx]
2017-11-23 The CAD models for thehe base of the drivetrain.
    [Base.ipt, Box.iam, Front.ipt, Long_Shaft.ipt, Short_Shaft.ipt, Side.ipt, inner_wall.ipt]
2017-12-02 Added the basic components of the drive train code including: pi control, powering dc motors, image recononision. Also commuinication with arduino has been done as well as the parsing of the map. Stu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
    [DriveTrain.py, Encoder.py, Graph.py, ImageRec.py, PI.py, Robot.py, UltraSonicCheck.py, drink.cpp]
2017-12-02 Fixing the angle to turn for navigation
    [Robot.py]
2017-12-24 Adding circuit diagrams and control sys diagrams
2018-01-02 add auth flow on robot side
2018-01-11 do not add http:// in case of beggining with https
2018-01-15 adding rasberry pi pin information
2018-01-15 Raspberry Pi electrical components table + 3d models
2018-01-15 All updated CAD mode models. I did them in AutoCAD and its the 3D design for the next deliverable.
    [Alfred_Frame.dwg, Base.ipt, Box.iam, Front.ipt, Long_Shaft.ipt, Short_Shaft.ipt, Side.ipt, inner_wall.ipt]
2018-01-15 The drawing with the BOM and exploded views.
    [IG_ALFRED.dwg]
2018-01-16 Updated Component Document CAD work
    [IG_ALFRED.dwg]
2018-01-17 Updated CAD Models and all the images that we need for the document.
    [IG_ALFRED.dwg]
2018-01-19 Added Cad Models to Design Notes
2018-01-28 Updated Encoder Mount model.
    [Encoder_Mount.dwg]
2018-01-30 Adding a test script for testing the motors
2018-02-01 bug fixes for Alfred RP code
    [DriveTrain.py, Encoder.py, Graph.py, ImageRec.py, Robot.py, UltraSonicCheck.py, move.py, server.py]
2018-02-17 bug fixes
    [Encoder_Mount_2013.dwg]
2018-02-18 minor buig fix to reaching the 5th column
    [pathFindingTest.py]
2018-02-18 headers for attaching file
2018-02-18 fix nozzle number
2018-02-19 try attaching file
2018-02-19 minor bug fix + test case class
    [pathFindingTest.py, pathFindingTestCases.py]
2018-02-19 bug fix and added testcases
    [pathFindingTest.py, pathFindingTestCases.py]
2018-02-19 couple of improvements and bug fixes
2018-02-27 added gearboxes
    [UP box 5 .stl, box 5 .stl]
2018-03-02 minor bug fix, fixed going through tables
    [DriveTrain.py, Graph.py, Robot.py, pathFindingTest.py, pathFindingTestCases.py]
2018-03-06 updated cad models for the gearbox
    [gearbox.dwg, gearbox_special_mod.dwg]
2018-03-06 added gearbox cad models
    [bottom_gearbox.stl, bottom_special.stl, top_gearbox.stl, top_special.stl]
2018-03-07 added sensor mount
    [sensor_mount.stl]
2018-03-07 update auth flow
2018-03-08 Updated gearbox models and speel check on hazard analysis rev 1
    [Encoder_Mount.dwg, Encoder_Mount_2013.dwg, UP box 5 .stl, bottom_gearbox.stl, bottom_special.stl, box 5 .stl, gearbox_v3.dwg, sensor_mount.stl]
2018-03-08 added 2010 version of dwg
    [new_gearbox_2010.dwg]
2018-03-16 Update System Design Doc with Traceability Matrix
2018-03-17 Im tired
2018-03-18 Completed coupler models, istall guide models and pumping mechanism models.
    [COUPLER.dwg, COUPLER_IG.dwg, IG_ALFRED.dwg, Pumping_System.dwg, new_gearbox_2010.dwg]
2018-04-01 adding pumping system code with weight sensor and adding modified code for closed loop testing
2018-04-05 added cost of items
    [Cost of items.xlsx]
2018-04-12 adding update cost information
    [Cost of items.xlsx]
2018-04-13 Updated V&V and modified traceability matrices.
2018-04-20 camera being accessed by different processes
2018-04-20 reset pins for encoders and sensor
2018-04-20 reset duty cycle after being blocked
    [DriveTrain.py]
2018-04-20 case problems on server
2018-04-20 shutdown and clean socket when stopping server
2018-04-20 changing ultrasonic stopping distance to 1m and caseinsensitive key for server tank_num
